christiantigor/smart_rectifier/board_sr/notes_sgp/pin_acs.jpeg

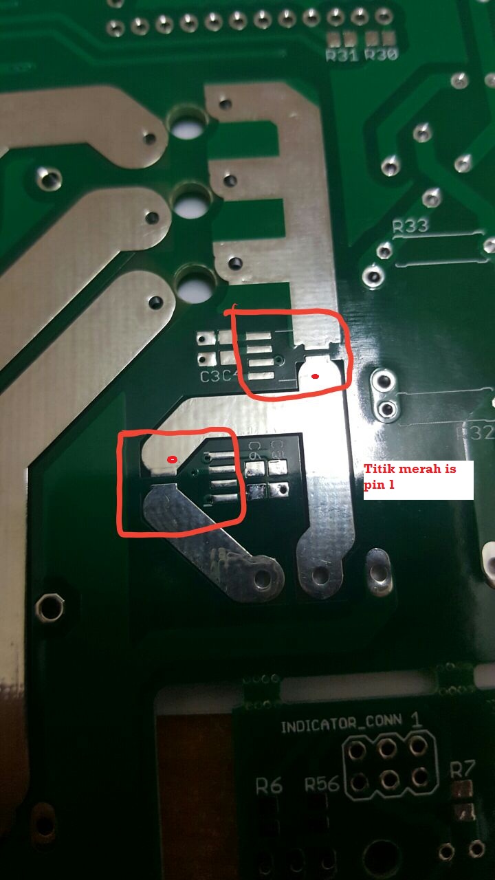
board_sr/notes_sgp/pin_acs.jpeg
