christiantigor/smart_rectifier/document/Troubleshooting.txt

Date and Time
sudo date -s "Wed Mar 16 11:56:45 WIB 2016"
