christiantigor/smart_rectifier/board_sr/sr_controller_v1/NOTES.txt

Revisi untuk board ver1 - OK
- Sudut - sudut buat melengkung
- Resistor dibawah SIM Card holder dipindahkan
- DS1307 dipindahkan sehingga tidak menghalangi spacer
- Tambah rangkaian rectifier untuk AC monitoring
- Tambah tombol reset
