christiantigor/smart_rectifier/casing_sr/TSR_Sticker.pdf

# TSR 15 - 500

01 02

# Switch

AC

# VBUC

+48V

# Switch Battery

# VSCPC

+48V

Hughes HX | VWiFi
Hughes HT iDirect X1&X3 | Bat (+)
| Bat (-)

SIM Net
SIM Stat

Rpi
Ardu

6.5V
19.5V

13.5V
24V - VWiFi

VBat
VSCPC

VAC
VBUC
