christiantigor/smart_rectifier/document/Gantt/TSR_Phase_3.png

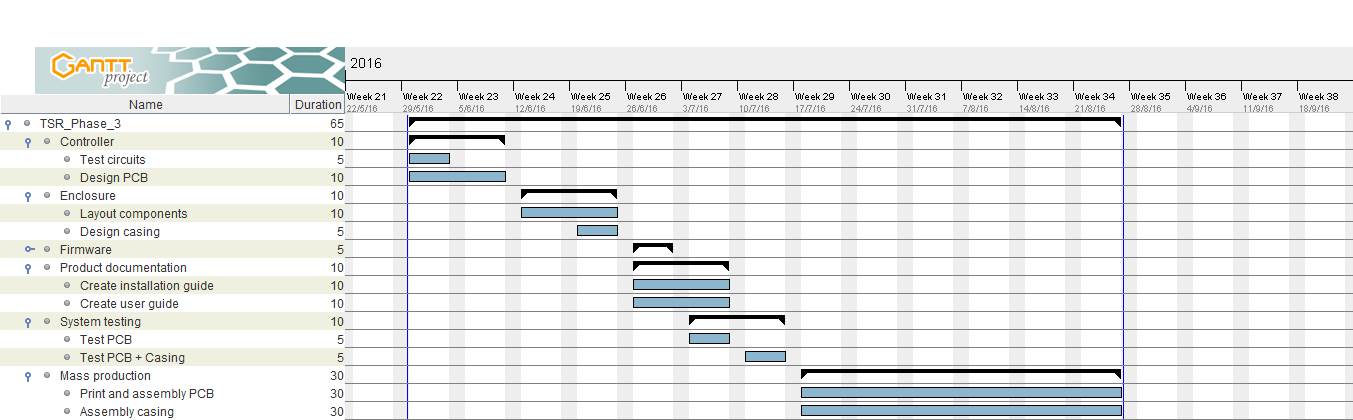
document/Gantt/TSR_Phase_3.png
