christiantigor/smart_rectifier/supply_sr/block_diagram.png

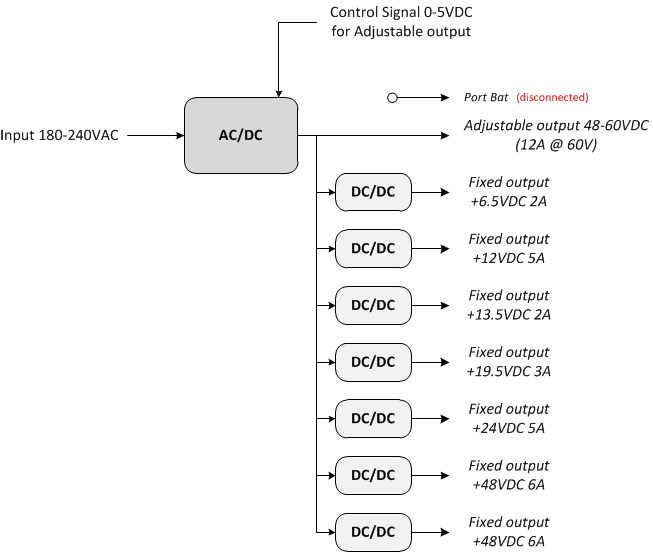
supply_sr/block_diagram.png
