christiantigor/smart_rectifier/supply_sr/block_diagram_rev_a.png

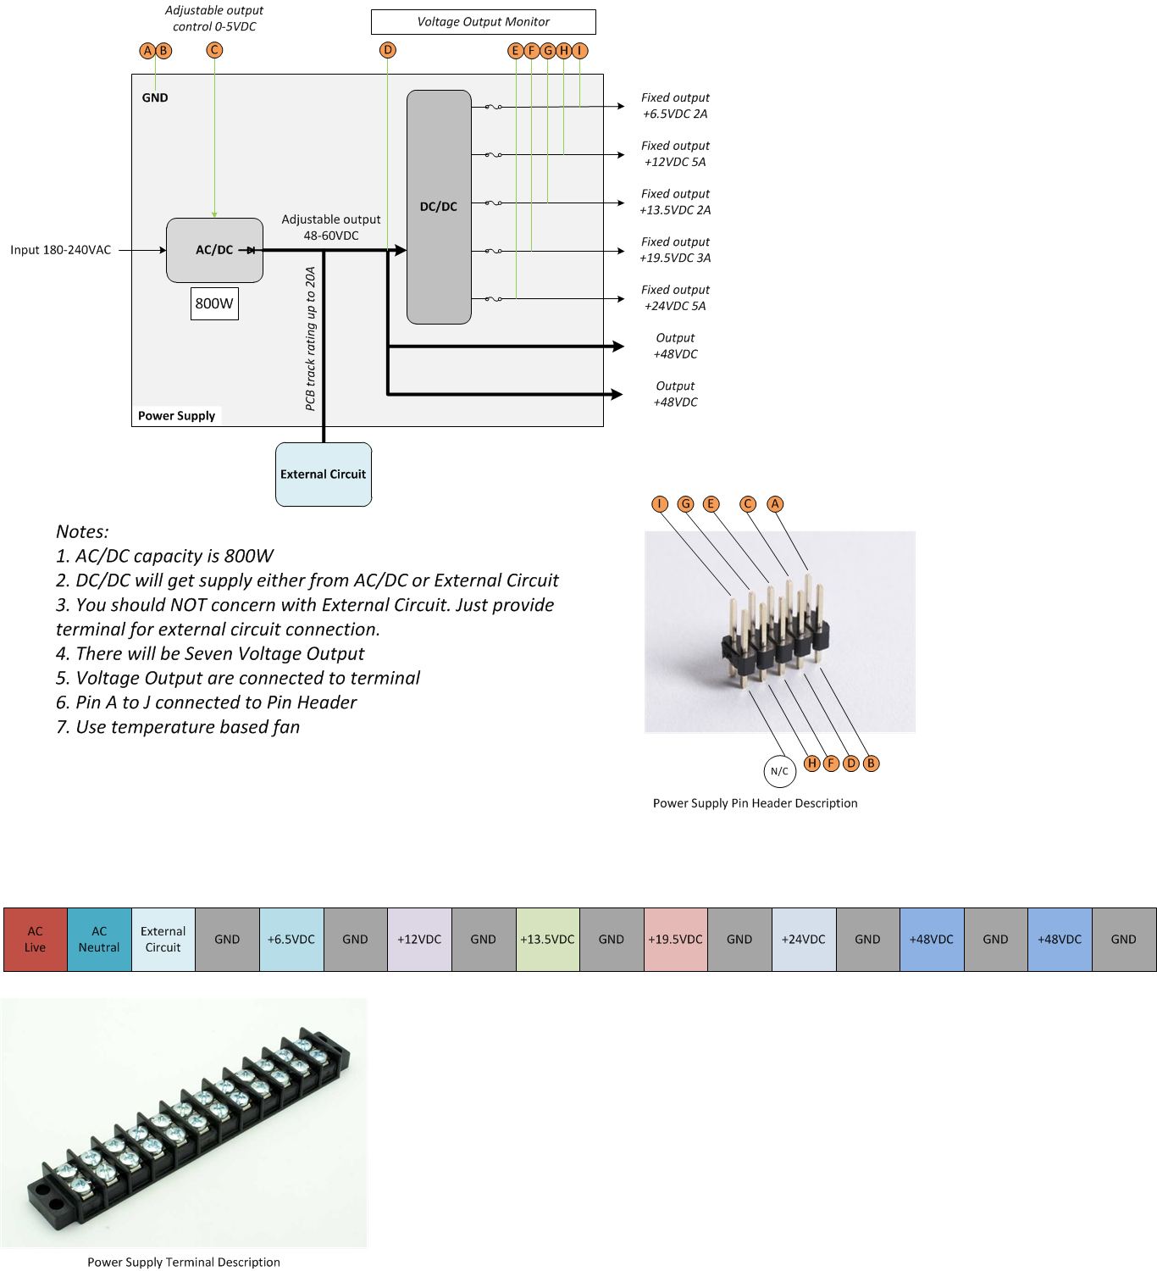
supply_sr/block_diagram_rev_a.png
