christiantigor/smart_rectifier/supply_sr/terminal.png

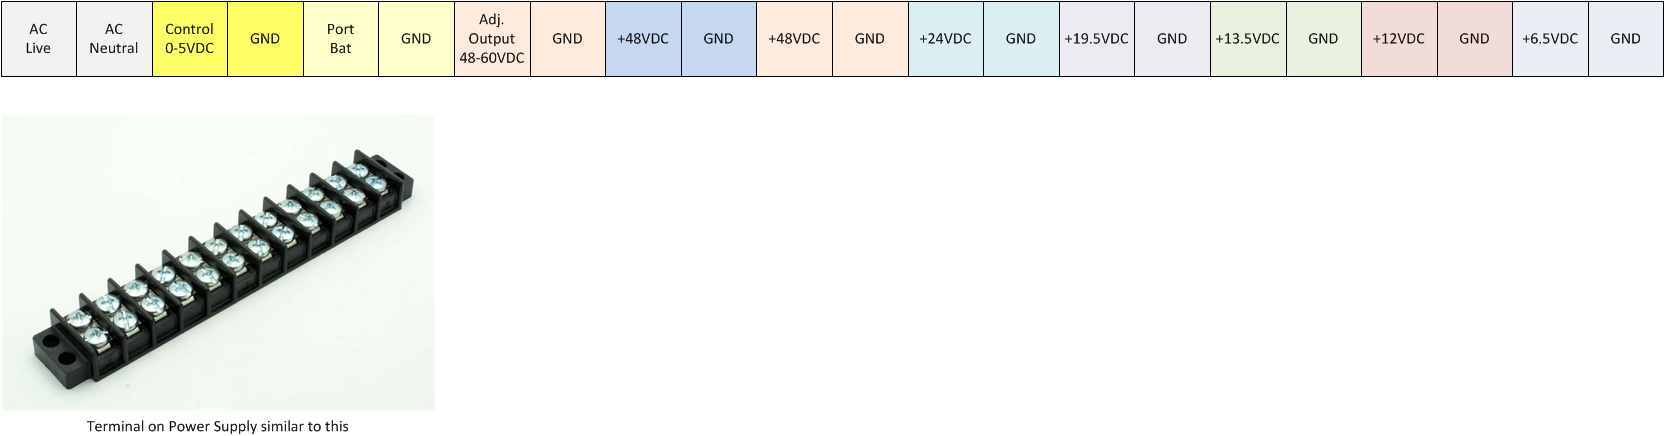
supply_sr/terminal.png
