christiantigor/smart_rectifier/board_sr/sr_controller_v1/sr_controller_v1_revD_BoM.xlsx

Reference | Part Number | Description | Value | Amount | Link
ADJ_VPWRSPLY, FROM_GREY_REG, FROM_LTC_REG_A, FROM_LTC_REG_B, TO_GREY_REG, TO_LTC_REG, VAC | AK300/2 | 2 Pin Blue Connector |  | 7
VPWRSPLY&VBAT | AK300/3 | 3 Pin Blue Connector |  | 1
OUT_+6V5, OUT_+12V, OUT_+13V5, OUT_+19V5, OUT_+24V, OUT_+48V_A, OUT_+48V_B | AK500/2 | 2 Pin Green Connector |  | 7
BAT1 | BATTERY20PTH | Battery Holders |  | 1
FAN | HEADER_1X02 | 2-Pin 0,254cm / 0.1 Header" |  | 1
LED1 | LEDCHIP-LED0805 | LED |  | 1
INDICATOR_CONN | MA03-2 | Male Pin Header |  | 1
T1 | MMBT2222ALT1-NPN-SOT23-BEC | NPN Transistror 2222 |  | 1
B1 | RB1A | Diode Bridge Rectifier |  | 1
U3 | RHT03_DHT-11_AM2302 | DHT 11 Temperature and Humidity Sensor |  | 1
U1 | RTC_DS1307 | DS1307 RTC |  | 1
SJ1, SJ2 | SOLDERJUMPER | leave this unassembled |  | 2
SJ3 | SOLDERJUMPERCLOSED | leave this unassembled |  | 1
SJ6 | SOLDERJUMPERREFLOW | solder the jumper |  | 1
RPI_RESET | TAC_SWITCHPTH | Tactile Switch |  | 1
D1, D2 | 1N4004 | DIODE | 1N4004 | 2
D3 | 1N4728 | Z DIODE | 1N4728 | 1
Q1 | CRYSTALTC38H | CRYSTAL | 32kHz | 1
F1, F2, F3 | BLADE_FUSE_HOLDER | Fuse Holder and The Fuse | 5A | 3
U$7, U$8 | 74HC4053D | Analog Mux | 74HC4053D | 2
U$2, U$4 | ACS712 | Current Sensor | ACS712 | 2
U$1 | ARDUINO_PRO_MINI | Female Pin Header | ARDUINO_PRO_MINI | 1
Q2 | BD140 | PNP TRANSISTOR | BD140 | 1
C3, C5 | C-EUC0805K | C0805 | C100nF | 2
C4, C6 | C-EUC0805K | C0805 | C1nF | 2
C1 | C-EUC0805 | C0805 | C4.7uF | 1
C2 | CPOL-EUE3.5-8 | leave this unassembled | C470uF | 1
U$3, U$6 | DCDCMODULE | Voltage Regulator | DCDCMODULE | 2
IC3 | LM741D | OP AMP | LM741D | 1
R6 | R-EU_R0805 | R0805 | R100K | 1
R55 | NTC642-6 | NTC Thermistor | R10K | 1
R1, R2, R4, R7, R9, R10, R12, R14, R15, R16, R24, R25, R26, R27, R28, R54 | R-EU_R0805 | R0805 | R10K | 16
R5 | R-EU_R0805 | R0805 | R150K | 1
R11, R13, R20, R21, R30, R53 | R-EU_R0805 | R0805 | R1K | 6
R8, R18 | R-EU_R0805 | R0805 | R220R | 2
R32 | R-EU_0309/10 | RESISTOR, European symbol | R270K | 1
R3, R31, R34 | R-EU_R0805 | R0805 | R2K | 3
R57 | R-EU_R0805 | R0805 | R47R | 1
R33 | R-EU_0309/10 | RESISTOR, European symbol | R5.1K | 1
R17, R22, R29 | R-EU_R0805 | R0805 | R5.1K | 3
PCB1 | RASPBERRY_PI_B+_NO_MOUNT | Male Pin Header | RASPBERRY_PI_B+_NO_MOUNT | 1
TV16 | TRANSFORMER | YHDC TV16 2.5mm Transformer | TRANSFORMER | 1
Notes:
Add tin layer on unmasked area on bottom layer
