christiantigor/smart_rectifier/board_sr/sr_indicator_v0/sr_indicator_v0_revB_BoM.xlsx

Reference | Part Number | Description | Value | Amount | Link
LD1 | DUOLED-RG-C | DUO LED |  | 1 | example (http://www.mpja.com/5mm-Red-Green-Bi-Color-LED-Diffused-3-Lead-Common-Cathode/productinfo/17136+OP/)
LED1 | LED5MM | LED |  | 1
INDICATOR_CONN | MA03-2 | PIN HEADER |  | 1
R5, R6, R7 | R-EU_M0805 | RESISTOR, European symbol | R150R | 3
