christiantigor/smart_rectifier/board_sr/sr_controller_v1/sr_controller_v1_revC_BoM.xlsx

Reference | Part Number | Description | Value | Amount | Link
ADJ_VPWRSPLY, FROM_GREY_REG, FROM_LTC_REG_A, FROM_LTC_REG_B, TO_GREY_REG, TO_LTC_REG, VAC, VBAT, VPWRSPLY | AK300/2 | 2 Pin Blue Connector |  | 9 | aliexpress (http://www.aliexpress.com/item/100-pcs-2-Pin-Screw-blue-PCB-Terminal-Block-Connector-5mm-Pitch/32368640798.html)
OUT_+6V5, OUT_+12V, OUT_+13V5, OUT_+19V5, OUT_+24V, OUT_+48V_A, OUT_+48V_B | AK500/2 | 2 Pin Green Connector |  | 7 | aliexpress (http://www.aliexpress.com/item/120-pcs-5-08mm-Angle-2-pin-Screw-Terminal-Block-Connector-Pluggable-Type-Green/32552709836.html)
BAT1 | BATTERY20PTH | Battery Holders |  | 1
INDICATOR_CONN | MA03-2 | Male Pin Header |  | 1
T1 | MMBT2222ALT1-NPN-SOT23-BEC | NPN Transistror 2222 |  | 1
B1 | RB1A | Bridge Rectifier |  | 1
U3 | RHT03_DHT-11_AM2302 | DHT 11 Temperature and Humidity Sensor |  | 1 | aliexpress (http://www.aliexpress.com/item/100pcs-lot-DHT11-Digital-Temperature-And-Humidity-Sensor-FZ0067-Free-Shipping-Dropshipping/877899250.html)
U1 | RTC_DS1307 | DS1307 RTC |  | 1
SJ1, SJ2, SJ4, SJ5 | SOLDERJUMPER | leave this unassembled
SJ3 | SOLDERJUMPERCLOSED | leave this unassembled
SJ6 | SOLDERJUMPERREFLOW | leave this unassembled
RPI_RESET | TAC_SWITCHPTH | Tactile Switch |  | 1
D1, D2 | 1N4004 | DIODE | 1N4004 | 2
D3 | 1N4728 | Z DIODE | 1N4728 | 1
FAN_A | 1X2-3.5MM | 3.5mm Terminal block | 1X2-3.5MM | 1 | image (http://lapantech.com/image/cache/data/white%20housing%202%20pin-384x384.JPG)
Q1 | CRYSTALTC38H | CRYSTAL | 32kHz | 1
F1, F2, F3 | BLADE_FUSE_HOLDER | FUSE HOLDER | 5A | 3 | tokopedia (https://www.tokopedia.com/lek-electronics/fuse-holder-blade-mini-pcb-mount-vertical)
U$8 | 74HC4053D | Analog Mux | 74HC4053D | 1
U$2, U$4 | ACS712 | Current Sensor | ACS712 30A | 2
U$1 | ARDUINO_PRO_MINI | Female Pin Header |  | 1
Q2 | BD140 | PNP TRANSISTOR | BD140 | 1
C3, C5 | C-EUC0805K | C0805 | C100nF | 2
C4, C6 | C-EUC0805K | C0805 | C1nF | 2
C1 | C-EUC0805 | C0805 | C4.7uF | 1
C2 | CPOL-EUE3.5-8 | POLARIZED CAPACITOR, European symbol | C470uF | 1
U$3, U$5, U$6, U$10 | DCDCMODULE | Voltage Regulator |  | 4 | aliexpress (http://www.aliexpress.com/item/DC-DC-Buck-Converter-Step-Down-Module-LM2596-Power-Supply-Output-1-23V-30V/846265709.html)
IC3 | LM741D | OP AMP | LM741D | 1
R6 | R-EU_R0805 | R0805 | R100K | 1
R55 | NTC642-6 | NTC Thermistor | R10K | 1
R1, R2, R4, R7, R10, R12, R14, R15, R16, R24, R25, R26, R27, R28, R54 | R-EU_R0805 | R0805 | R10K | 15
R5 | R-EU_R0805 | R0805 | R150K | 1
R11, R13, R20, R21, R30, R53 | R-EU_R0805 | R0805 | R1K | 6
R8 | R-EU_R0805 | R0805 | R220R | 1
R32 | R-EU_0309/10 | RESISTOR, European symbol | R270K | 1
R3, R31, R34 | R-EU_R0805 | R0805 | R2K | 3
R57 | R-EU_R0805 | R0805 | R47R | 1
R33 | R-EU_0309/10 | RESISTOR, European symbol | R5.1K | 1
R17, R29 | R-EU_R0805 | R0805 | R5.1K | 2
R22 | R-EU_R0805 | R0805 | R5K | 1
PCB1 | RASPBERRY_PI_B+_NO_MOUNT | Male Pin Header | Male Pin Header 2x20 | 1
TV16 | TRANSFORMER | YHDC TV16 2.5mm Transformer | TRANSFORMER | 1 | aliexpress (http://www.aliexpress.com/store/product/YHDC-TV16-250V-2mA-PCB-mount-Voltage-transformer/834088_32294917189.html)
J2, J3, J4, J5, J6, J7, J8, J9 | WIRE_HOLE-14AWG | Connect with 14 AWG Wire | WIRE_HOLE-14AWG | 8
 |  | J2 to J3
 |  | J4 to J5
 |  | J6 to J7
 |  | J8 to J9
