christiantigor/smart_rectifier/board_sr/sr_controller_v1/sr_controller_v1_revB_BoM.xlsx

Reference | Part Number | Description | Value | Amount | Link
BUC_SPLY, MDM_REG_A, MDM_REG_B, SCADA_REG_A, SCADA_REG_B, SCPC_SPLY, TO_LTC_REG, VAC, V_ACCU, V_PWR_SPLY | AK300/2 | 2 Pin Blue Connector |  | 10 | aliexpress (http://www.aliexpress.com/item/100-pcs-2-Pin-Screw-blue-PCB-Terminal-Block-Connector-5mm-Pitch/32368640798.html)
FROM_LTC_REG | AK300/3 | 3 Pin Blue Connector |  | 1 | aliexpress (http://www.aliexpress.com/item/50-pcs-3-Pin-Screw-blue-PCB-Terminal-Block-Connector-5mm-Pitch-301-3P/32616498533.html)
MDM_SPLY_HT_X1_X3 | AK300/5 | 5 Pin Green Connector |  | 1 | aliexpress (http://www.aliexpress.com/item/5-Pcs-Pitch-5-08mm-Angle-5way-pin-Screw-Terminal-Block-Connector-Green-Color-L-Pluggable/1837966907.html)
MDM_SPLY_HX_A, MDM_SPLY_HX_B, SCADA_SPLY | AK500/2 | 2 Pin Green Connector |  | 3 | aliexpress (http://www.aliexpress.com/item/120-pcs-5-08mm-Angle-2-pin-Screw-Terminal-Block-Connector-Pluggable-Type-Green/32552709836.html)
BAT1 | BATTERY20PTH | Battery Holders |  | 1
IC1 | GSM_SIM900_LITERAL | leave this unassembled |  | -
LED1, LED2 | LEDCHIPLED_0805 | leave this unassembled |  | -
INDICATOR_CONN | MA08-2 | Male Pin Header |  | 1
T1, T2, T3, T4 | MMBT2222ALT1-NPN-SOT23-BEC | NPN Transistror 2222 |  | 4
U3 | RHT03_DHT-11_AM2302 | DHT 11 Temperature and Humidity Sensor |  | 1 | aliexpress (http://www.aliexpress.com/item/100pcs-lot-DHT11-Digital-Temperature-And-Humidity-Sensor-FZ0067-Free-Shipping-Dropshipping/877899250.html)
U1 | RTC_DS1307 | DS1307 RTC |  | 1
J1 | SIMHOLDERSIM | leave this unassembled |  | -
X1 | SMACONNECTOR | leave this unassembled |  | -
SJ1, SJ2 | SOLDERJUMPER | leave this unassembled |  | -
SJ3 | SOLDERJUMPERCLOSED | leave this unassembled |  | -
RPI_RESET | TAC_SWITCHPTH | Tactile Switch |  | 1
D3 | TVSARRAY_5LANE | leave this unassembled |  | -
F3 | FUSE2P | Fuse | 10A | 1
D1 | DIODE-DO214AA | Diode | 1N4007 | 1
FAN_A, FAN_B | 1X2-3.5MM | 3.5mm Terminal block | 1X2-3.5MM | 2 | image (http://lapantech.com/image/cache/data/white%20housing%202%20pin-384x384.JPG)
Q1 | CRYSTALTC38H | Crystal | 32kHz | 1
F1, F5 | FUSE2P | Fuse | 4A | 2
U$8 | 74HC4053D | Analog Mux | 74HC4053D | 1
IC2 | 74HC595D | Shift Register | 74HC595D | 1
F4 | FUSE2P | Fuse | 7A | 1
U$2, U$4 | ACS712 | Current Sensor | ACS712 30A | 2
U$1 | ARDUINO_PRO_MINI | Female Pin Header |  | 1
C2, C3, C5 | C-EUC0805K | C0805 | C100N | 3
C10, C12 | C-EUC0805 | C0805 | C100nF | 2
C7, C8 | CPOL-EU153CLV-0605 | Cap Alumunium SMD Polar 0605 | C100uF | 2 | aliexpress (http://www.aliexpress.com/item/SMD-aluminum-electrolytic-capacitor-16V-100UF-6X5-4-100UF-16V-6-5-4-Original-new-Special/32260015566.html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)
C4, C6 | C-EUC0805K | C0805 | C1N | 2
C11, C13 | C-EUC0805 | C0805 | C22pF | 2
C1, C9 | C-EUC0805 | C0805 | C4.7uF | 2
U$3, U$6 | DCDCMODULE | Voltage Regulator |  | 2 | aliexpress (http://www.aliexpress.com/item/DC-DC-Buck-Converter-Step-Down-Module-LM2596-Power-Supply-Output-1-23V-30V/846265709.html)
L1 | L0603 |  | FB0603 | 1 | aliexpress (http://www.aliexpress.com/item/100PCS-0603-150R-150-ohm-SMD-Magnetic-beads-150R-150-ohm-450MA-Ferrite-Universal-BLM18BB151SN1D-BLM18BB151SN1/1926258569.html)
K1 | G5L | RELAY | G5L 12V 10A | 1 | aliexpress (http://www.aliexpress.com/item/Free-shipping-HRS4H-S-DC12V-Relay-electronic-stock-new-original/1634903116.html)
R1, R2, R4, R7, R10, R12, R14, R15, R16, R22, R25, R28, R37, R38, R39, R40, R41, R42, R43, R44, R45, R46, R47, R48, R49, R50, R51 | R-EU_R0805 | R0805 | R10K | 27
R27 | R-EU_R0805 | R0805 | R120R | 1
R5, R6, R11, R13, R21, R24, R30, R35, R36, R53 | R-EU_R0805 | R0805 | R1K | 10
R33 | R-EU_0309/10 | RESISTOR, European symbol | R2.2K | 1
R8, R23, R26 | R-EU_R0805 | R0805 | R220R | 3
R18, R19, R20 | R-EU_R0805 | R0805 | R22R | 3
R32 | R-EU_0309/10 | RESISTOR, European symbol | R270K | 1
R3, R31, R34 | R-EU_R0805 | R0805 | R2K | 3
R9, R52 | R-EU_R0805 | R0805 | R470K | 2
R17, R29 | R-EU_R0805 | R0805 | R5.1K | 2
PCB1 | RASPBERRY_PI_B+_NO_MOUNT | Male Pin Header | Male Pin Header 2x20 | 1
TV16 | TRANSFORMER | YHDC TV16 2.5mm Transformer | TRANSFORMER | 1 | aliexpress (http://www.aliexpress.com/store/product/YHDC-TV16-250V-2mA-PCB-mount-Voltage-transformer/834088_32294917189.html)
J2, J3, J4, J5, J6, J7, J8, J9 | WIRE_HOLE-14AWG | Connect with 14 AWG Wire | WIRE_HOLE-14AWG | 8
 |  | J2 to J3
 |  | J4 to J5
 |  | J6 to J7
 |  | J8 to J9
