christiantigor/smart_rectifier/board_sr/sr_indicator_v0/sr_indicator_v0_BoM.xlsx

Reference | Part Number | Description | Value | Amount
ARDUF, CL0, CL1, CL2, CL3, CL4, CL5, CL6, CL7, CL8, CL9, RPIF, SIMN, SIMS | LED3MM | LED |  | 14
CTRL_CONN | MA08-2 | Male Pin Header |  | 1
R1, R2, R3, R4, R5, R6, R7, R8, R9, R10, R11, R12, R13, R14 | R-EU_M0805 | R0805 | R220R | 14
IC1, IC2 | ULN2004AD | Driver Array | ULN2004AD | 2
