christiantigor/smart_rectifier/board_sr/sr_indicator_v0/sr_indicator_v0.stl

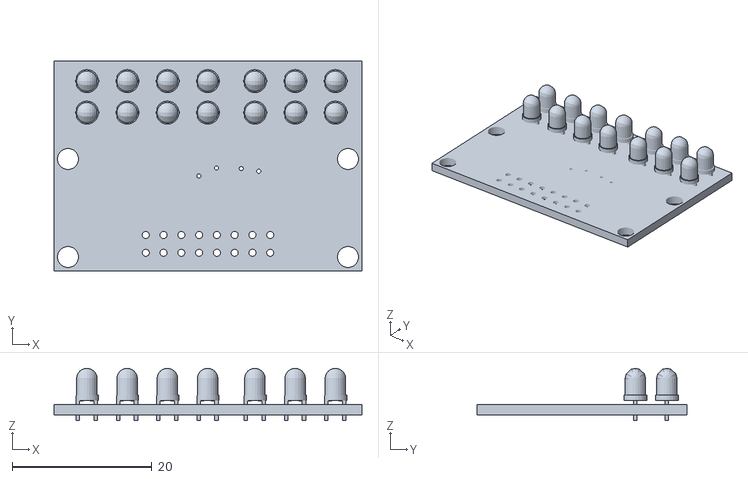
[picture p6: CAD file, 2015-11-06]
board_sr/sr_indicator_v0/sr_indicator_v0.stl
44.0 x 30.0 x 7.48
