christiantigor/smart_rectifier/board_sr/ver_7/sr_controller_v0.stl

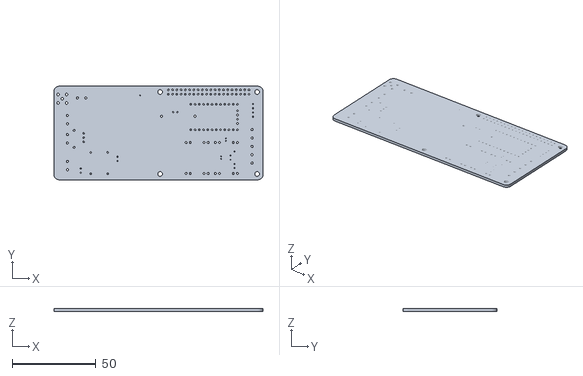
[picture p7: CAD file, 2015-10-19]
board_sr/ver_7/sr_controller_v0.stl
125.0 x 56.0 x 1.50
