christiantigor/smart_rectifier/model/User Library-AC Male Socket with Fuse.stl

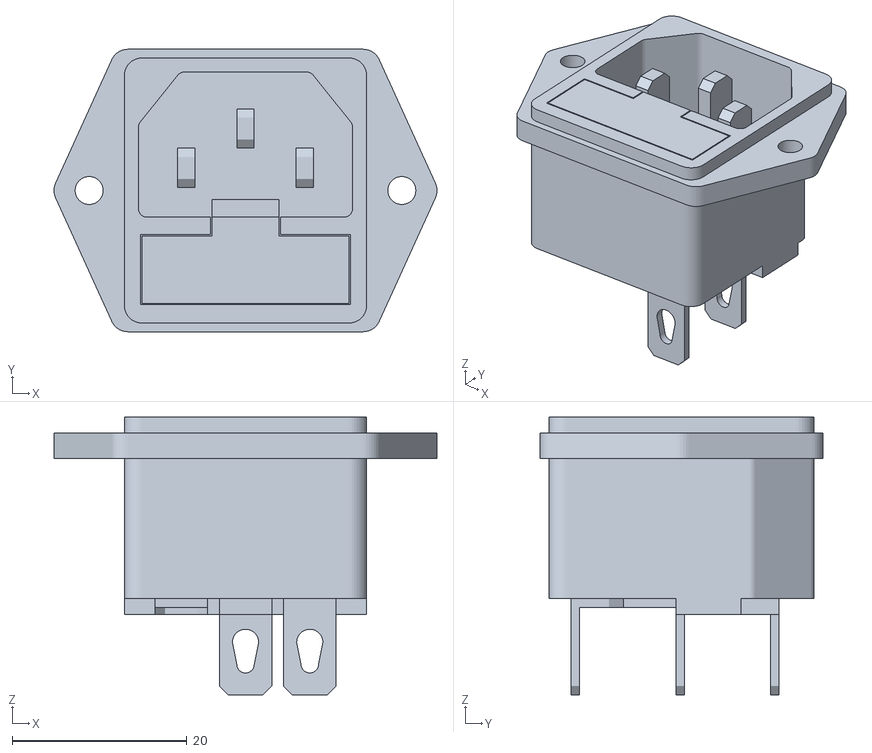
[picture p8: CAD file, 2015-10-19]
model/User Library-AC Male Socket with Fuse.stl
43.8 x 32.3 x 31.8
