christiantigor/smart_rectifier/model/User Library-Switch MIRS-101-2C Red.stl

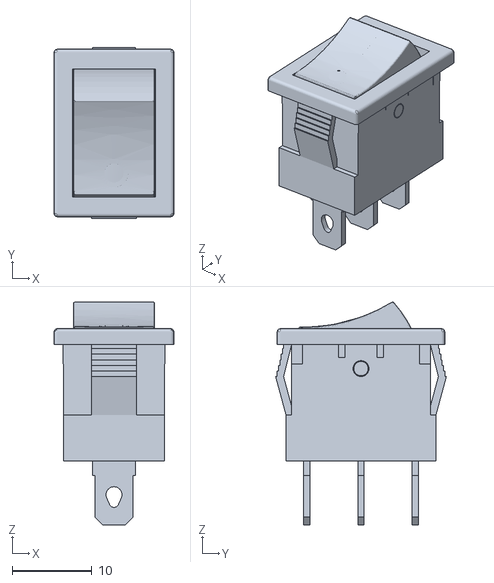
[picture p9: CAD file, 2015-10-19]
model/User Library-Switch MIRS-101-2C Red.stl
15.0 x 21.4 x 27.9
