christiantigor/smart_rectifier/program_sr/rpi/testing/chargingTest.txt

Procedure:
- Truncate DB history (if necessary)
- Turn off cronjob
reboot
- Run pigpiod
- Start prtgprobe
- Run getSensorData.py
- Run control switch manual
