christiantigor/smart_rectifier/program_sr/sensorCalibration.xlsx

Sensor Name | Sensor Value | R1 | R2 | ADC Value | Calibration
VAC
VBat | 50.2 | 10 | 0.22 | 221.3122505 | 0.2268288
BUC | 48 | 10 | 1 | 893.6727273 | 0.0537109
SCADA | 12 | 10 | 5.1 | 830.0503311 | 0.014457
SCPC | 48 | 10 | 1 | 893.6727273 | 0.0537109
Modem0 | 6.5 | 10 | 10 | 665.6 | 0.0097656
Modem1 | 13.5 | 10 | 5.1 | 933.8066225 | 0.014457
Modem2 | 19.5 | 10 | 2 | 665.6 | 0.0292969
Modem3 | 24 | 10 | 2 | 819.2 | 0.0292969
Sensor Name | Sensitivity(V/A) | Unit ADC in Volt(V/ADC) | Unit ADC in Amp(A/ADC)
IBat | 0.066 | 0.0048828125 | 0.073982
ILoad | 0.066 | 0.0048828125 | 0.073982
