christiantigor/smart_rectifier/program_sr/vacCalibration.xlsx

Sheet: Sheet1
x | y | xy | x2 | y2 | n | Σ x | Σ y | Σ xy | Σx2 | Σy2
473 | 220 | 104060 | 223729 | 48400 | 5 | 2245 | 900 | 406980 | 1010281 | 166000
462 | 200 | 92400 | 213444 | 40000
458 | 180 | 82440 | 209764 | 32400 |  | (Σx)2 | (Σy)2
440 | 160 | 70400 | 193600 | 25600 |  | 5040025 | 810000
412 | 140 | 57680 | 169744 | 19600
 |  |  |  |  |  | m | 1.265377856
 |  |  |  |  |  | b | -388.1546573
 |  |  |  |  |  | x is adc
 |  |  |  |  |  | y is vac
 |  |  |  |  |  | y = mx +b

Sheet: Sheet2
x | y | xy | x2 | y2 | n | Σ x | Σ y | Σ xy | Σx2 | Σy2
479 | 220 | 105380 | 229441 | 48400 | 5 | 2361 | 900 | 425700 | 1114995 | 166000
476 | 200 | 95200 | 226576 | 40000
473 | 180 | 85140 | 223729 | 32400 |  | (Σx)2 | (Σy)2
468 | 160 | 74880 | 219024 | 25600 |  | 5574321 | 810000
465 | 140 | 65100 | 216225 | 19600
 |  |  |  |  |  | m | 5.504587156
 |  |  |  |  |  | b | -2419.266055
 |  |  |  |  |  | x is adc
 |  |  |  |  |  | y is vac
 |  |  |  |  |  | y = mx +b
