christiantigor/smart_rectifier/program_sr/rpi/testing/chargingLoad.xlsx

 |  | VBAT | IBAT | ILOAD
2015-11-24 | 16:28:07 | 48.32 | -5.99 | 5.47 | Tanpa charging dan beban terhubung
2015-11-24 | 16:28:23 | 48.32 | -5.99 | 5.4
2015-11-24 | 16:28:39 | 48.32 | -5.99 | 5.47
2015-11-24 | 16:28:55 | 48.32 | -5.99 | 5.4
2015-11-24 | 16:29:16 | 48.32 | -5.99 | 5.47
2015-11-24 | 16:29:32 | 48.32 | -5.99 | 5.47
2015-11-24 | 16:29:48 | 48.32 | -5.99 | 5.47
2015-11-24 | 16:30:04 | 48.32 | -5.99 | 5.47
2015-11-24 | 16:30:20 | 48.32 | -5.99 | 5.47
2015-11-24 | 16:30:36 | 48.32 | -5.99 | 5.47
2015-11-24 | 16:30:52 | 48.32 | -5.99 | 5.47
2015-11-24 | 16:31:08 | 48.32 | -5.99 | 5.47
2015-11-24 | 16:31:24 | 51.12 | 6.95 | 5.92 | Charging dan beban terhubung
2015-11-24 | 16:31:40 | 51.82 | 6.81 | 5.99
2015-11-24 | 16:31:56 | 53.22 | 6.66 | 5.99
2015-11-24 | 16:32:22 | 53.92 | 6.36 | 6.07
2015-11-24 | 16:32:38 | 54.38 | 6.29 | 6.14
2015-11-24 | 16:32:59 | 54.62 | 6.21 | 6.07
2015-11-24 | 16:33:15 | 54.62 | 5.99 | 6.07
2015-11-24 | 16:33:31 | 58.12 | 11.69 | 0.15 | Fuse putus
2015-11-24 | 16:33:47 | 56.72 | 9.91 | 0.15
2015-11-24 | 16:34:03 | 58.35 | 9.32 | -0.07
2015-11-24 | 16:34:19 | 57.65 | 9.03 | -0.07
2015-11-24 | 16:34:35 | 57.89 | 8.66 | 0.15
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
