christiantigor/smart_rectifier/program_sr/rpi/testing/chargingWOLoad.xlsx

2015-11-24 | 14:18:56 | 573 | 50.88 | -0.52 | 0 | Hughes HX-50 | 6.59 | 13.56 | 19.58 | 24.19 | 50.8 | 50.94 | 12 | 27 | 0
2015-11-24 | 14:19:12 | 566 | 50.88 | -0.52 | 0 | Hughes HX-50 | 6.59 | 13.57 | 19.58 | 24.19 | 50.86 | 50.94 | 12 | 26 | 0
2015-11-24 | 14:19:28 | 598 | 50.88 | -0.52 | 0 | Hughes HX-50 | 6.59 | 13.57 | 19.58 | 24.19 | 50.8 | 50.88 | 12 | 26 | 0
2015-11-24 | 14:19:44 | 556 | 50.88 | -0.52 | 0 | Hughes HX-50 | 6.59 | 13.57 | 19.58 | 24.19 | 50.8 | 50.88 | 11.98 | 27 | 0
2015-11-24 | 14:20:00 | 596 | 50.88 | -0.52 | 0 | Hughes HX-50 | 6.59 | 13.57 | 19.58 | 24.19 | 50.8 | 50.88 | 12 | 27 | 0
2015-11-24 | 14:20:16 | 561 | 50.88 | -0.52 | 0 | Hughes HX-50 | 6.59 | 13.56 | 19.58 | 24.19 | 50.86 | 50.88 | 12.01 | 27 | 0
2015-11-24 | 14:20:32 | 560 | 50.88 | -0.52 | 0 | Hughes HX-50 | 6.59 | 13.57 | 19.58 | 24.19 | 50.8 | 50.88 | 12 | 27 | 0
2015-11-24 | 14:20:58 | 585 | 50.88 | -0.52 | -0.15 | Hughes HX-50 | 6.59 | 13.57 | 19.61 | 24.19 | 50.91 | 50.99 | 12.05 | 27 | 0
2015-11-24 | 14:21:14 | 596 | 50.88 | -0.52 | -0.07 | Hughes HX-50 | 6.59 | 13.56 | 19.58 | 24.19 | 50.8 | 50.88 | 12 | 26 | 0
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
