christiantigor/smart_rectifier/program_sr/rpi/sensorHistory.txt

tdate	ttime	sensorVAC	sensorVBat	sensorIBat	sensorILoad	modemType	sensorModem0	sensorModem1	sensorModem2	sensorModem3	sensorBUC	sensorSCPC	sensorSCADA	sensorTemp	sendStatus
2015-11-29	19:16:03	402	50.65	-0.52	0.15	Hughes HX-50	6.61	13.59	19.58	24.16	50.53	50.56	11.98	25	1
2015-11-29	19:18:09	403	50.65	-0.52	0.15	Hughes HX-50	6.61	13.59	19.58	24.16	50.53	50.56	11.98	25	1
2015-11-29	19:20:13	403	50.65	-0.52	0.15	Hughes HX-50	6.61	13.59	19.61	24.16	50.48	50.51	11.98	25	1
2015-11-29	19:22:04	403	50.65	-0.52	0.15	Hughes HX-50	6.61	13.59	19.61	24.19	50.48	50.51	11.98	25	1
2015-11-29	19:24:05	403	50.65	-0.52	0.15	Hughes HX-50	6.61	13.59	19.58	24.16	50.48	50.51	11.98	25	1
2015-11-29	19:26:04	403	50.65	-0.52	0.15	Hughes HX-50	6.61	13.59	19.58	24.16	50.43	50.51	11.98	25	1
2015-11-29	19:28:14	405	50.65	-0.52	0.15	Hughes HX-50	6.61	13.59	19.61	24.16	50.43	50.51	11.98	26	1
2015-11-29	19:30:05	406	50.42	-0.52	0.15	Hughes HX-50	6.61	13.59	19.58	24.16	50.43	50.51	11.98	26	1
2015-11-29	19:32:04	405	50.42	-0.52	0.15	Hughes HX-50	6.61	13.59	19.61	24.16	50.43	50.45	11.98	26	1
2015-11-29	19:34:04	405	50.42	-0.52	0.15	Hughes HX-50	6.61	13.59	19.61	24.16	50.43	50.45	11.98	26	1
2015-11-29	19:36:04	405	50.42	-0.52	0.15	Hughes HX-50	6.61	13.59	19.58	24.16	50.43	50.45	11.98	26	1
2015-11-29	19:38:04	405	50.42	-0.52	0.15	Hughes HX-50	6.61	13.59	19.61	24.16	50.37	50.45	11.98	25	1
2015-11-29	19:40:04	406	50.42	-0.52	0.15	Hughes HX-50	6.61	13.59	19.58	24.16	50.37	50.4	11.98	25	1
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
2015-12-08	23:17:28	228.71	50.88	-0.52	0.15	NULL	6.61	13.57	19.58	24.16	50.64	50.67	11.97	25	0
2015-12-08	23:17:29	217.7	50.65	-0.52	0.15	NULL	6.61	13.57	19.61	24.16	50.64	50.67	11.98	25	1
2015-12-08	23:17:30	228.71	50.88	-0.52	0.22	NULL	6.61	13.57	19.58	24.16	50.64	50.67	11.98	25	1
