christiantigor/smart_rectifier/casing_sr/TSR_v0.pdf

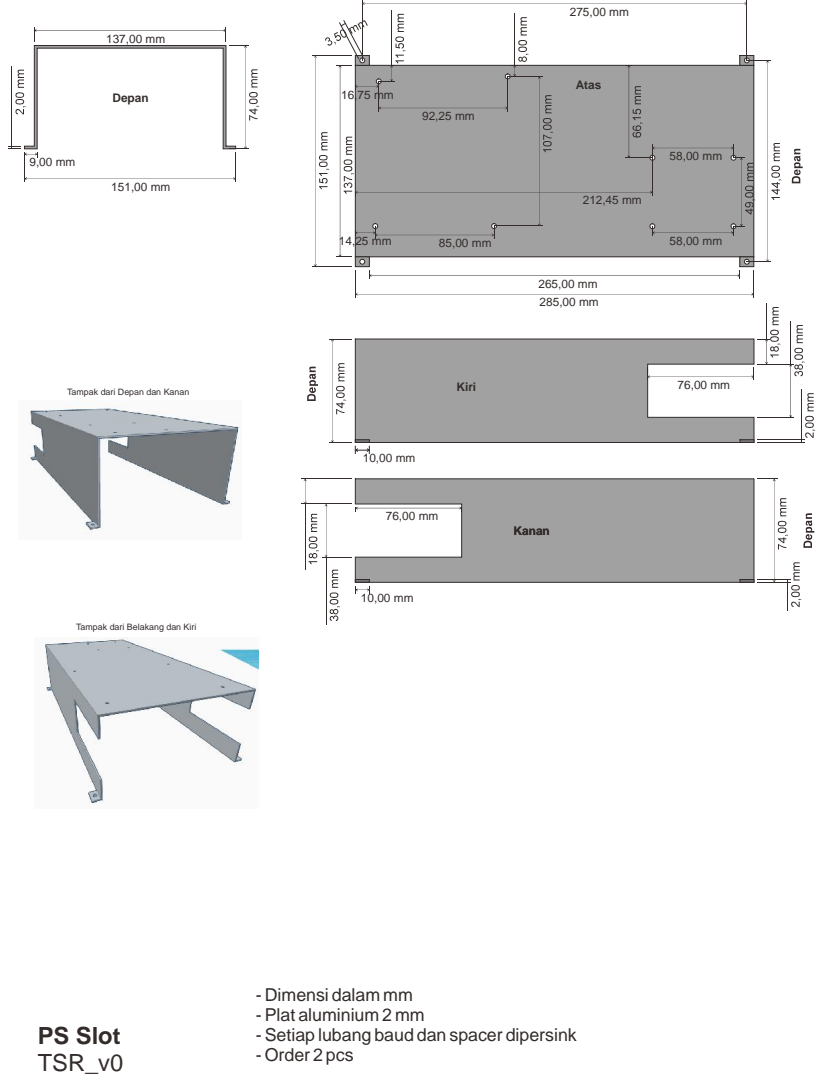
[picture p10: page 1]
Kiri; Kanan; Tampak dari Depan dan Kanan; Atas; Depan; PS Slot TSR_v0

Tampak dari Belakang dan Kiri

- Dimensi dalam mm
- Plat aluminium 2 mm
- Setiap lubang baud dan spacer dipersink
- Order 2 pcs

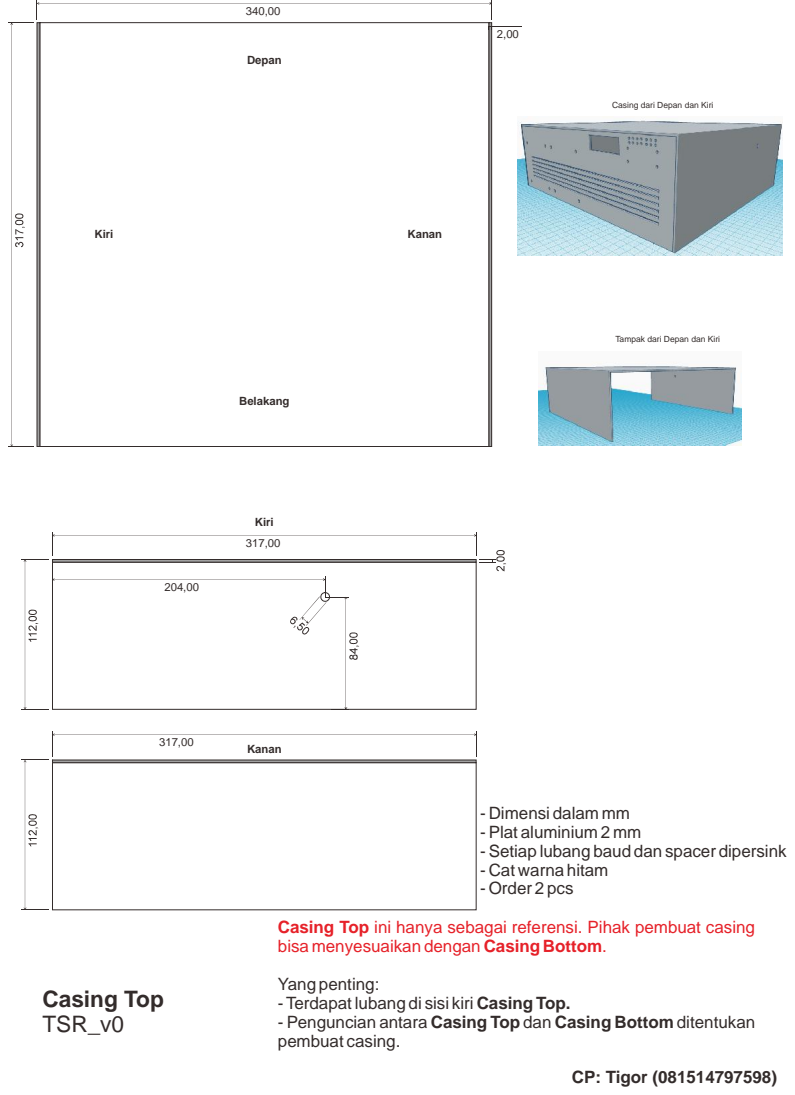
[picture p11: page 2]
Depan; Belakang; Kiri; Kanan; Kanan 317,00; Casing Bottom; bisa menyesuaikan dengan; - Penguncian antara; dan; ditentukan; Casing Top.; Casing Top; CP: Tigor (081514797598)

Casing dari Depan dan Kiri

Tampak dari Depan dan Kiri

- Dimensi dalam mm
- Plat aluminium 2 mm
- Setiap lubang baud dan spacer dipersink
- Cat warna hitam
- Order 2 pcs

Casing Top
Yang penting:
- Terdapat lubang di sisi kiri
pembuat casing.

ini hanya sebagai referensi. Pihak pembuat casing

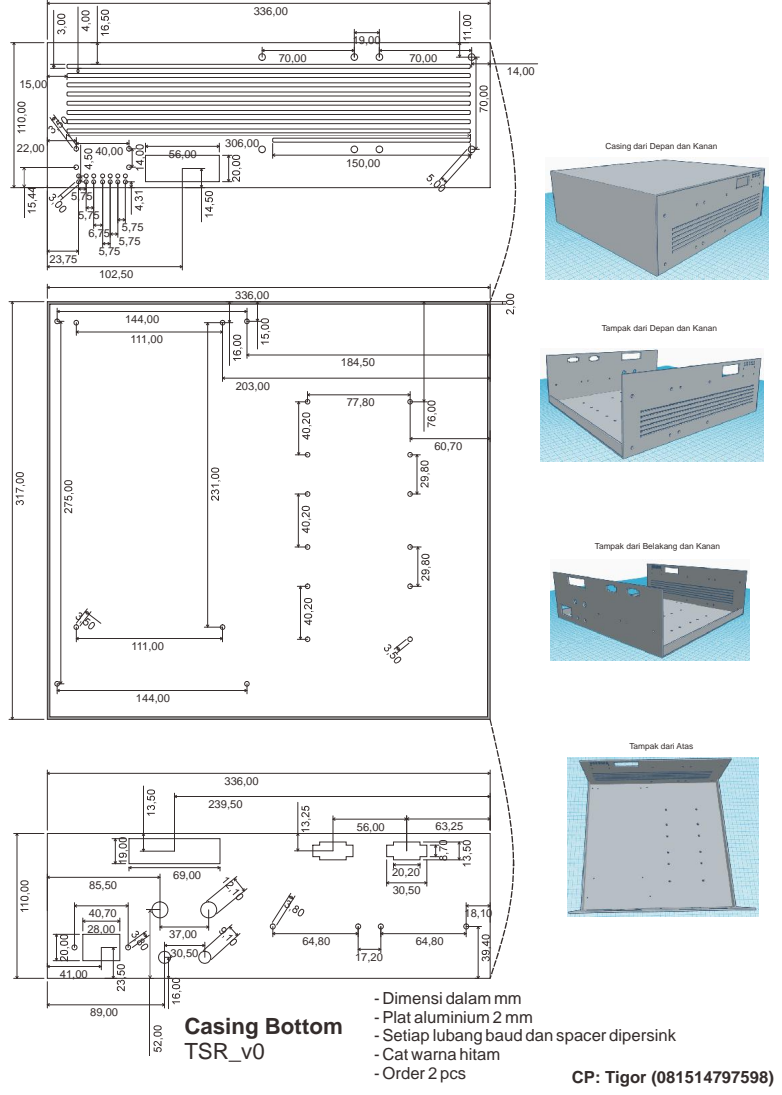
[picture p12: page 3]
Casing Bottom; CP: Tigor (081514797598)

Casing dari Depan dan Kanan

Tampak dari Depan dan Kanan

Tampak dari Belakang dan Kanan

Tampak dari Atas

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
