christiantigor/smart_rectifier/casing_sr/PS_Slot.pdf

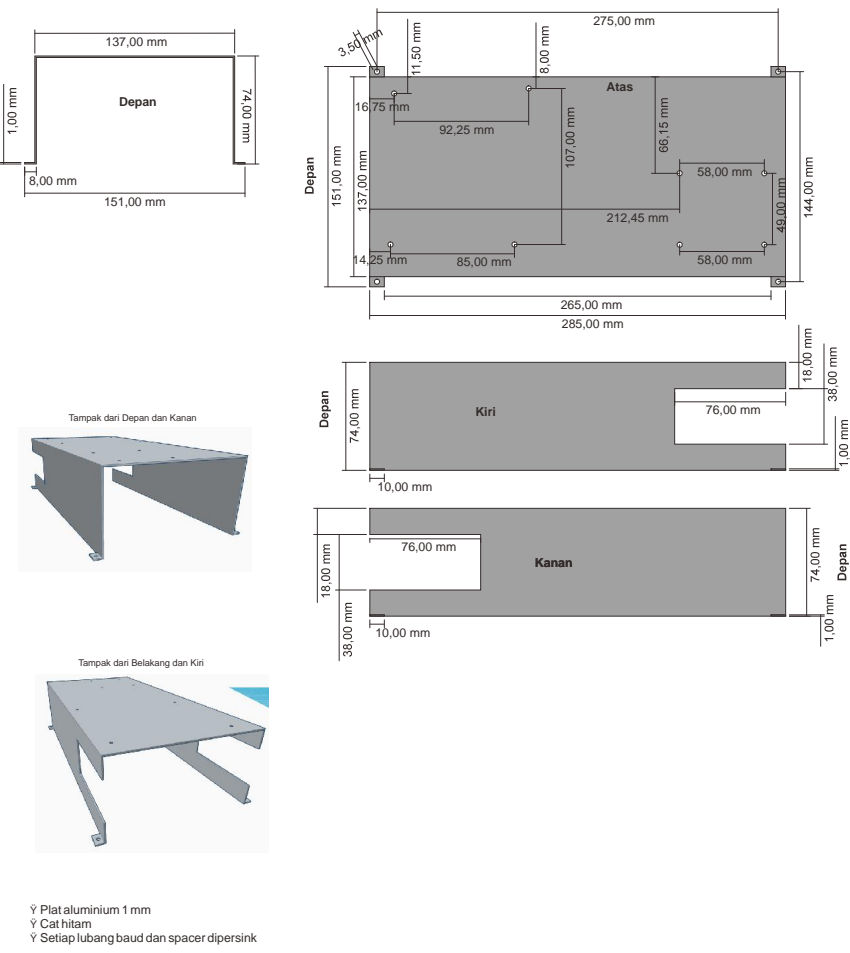
[picture p13: page 1]
Kiri; Kanan; Tampak dari Depan dan Kanan; Atas; Depan

Tampak dari Belakang dan Kiri

Plat aluminium 1 mm
Cat hitam
Setiap lubang baud dan spacer dipersink
