christiantigor/smart_rectifier/board_sr/sr_controller_v1/sr_controller_v1_revA.brd

## EAGLE design board_sr/sr_controller_v1/sr_controller_v1_revA.brd (2017-06-01)

Schematic: sr_controller_v1_revA.sch

Parts:
BAT1: BATTERY20PTH; BATTCOM_20MM_PTH
BUC_SPLY: AK300/2
C1, C9: C4.7uF; C0805
C3, C5, C14: C100N; C0805K
C4, C6: C1N; C0805K
C7, C8: C100uF; 153CLV-0605
C10, C12: C100nF; C0805
C11, C13: C22pF; C0805
D1: 1N4007; DO214AA
D3: TVSARRAY_5LANE; SOT363
DUMMY_A: AK500/2
DUMMY_B: AK500/2
DUMMY_C: AK500/2
F1, F5: 4A; FUSE1
F3: 10A; FUSE1
F4: 7A; FUSE1
FAN_A: 1X2-3.5MM
FAN_B: 1X2-3.5MM
FROM_LTC_REG: AK300/3
IC1: GSM_SIM900_LITERAL; SIM900_SMT
IC2: 74HC595D; SO16
INDICATOR_CONN: MA08-2
J1: SIMHOLDERSIM; SIMHOLDER
J2, J3, J4, J5, J6, J7, J8, J9: WIRE_HOLE-14AWG
K1: G5L; G5LE
LED1, LED2: LEDCHIPLED_0805; CHIPLED_0805
MDM_REG_A: AK300/2
MDM_REG_B: AK300/2
MDM_SPLY_HT_X1_X3: AK300/5
MDM_SPLY_HX_A: AK500/2
MDM_SPLY_HX_B: AK500/2
PCB1: RASPBERRY_PI_B+_NO_MOUNT; RASPBERRY_PI_B+
Q1: 32kHz; TC38H
R1, R2, R4, R7, R10, R12, R14, R15, R16, R22, R25, R28, R37, R38, R39, R40, R41, R42, R43, R44, R45, R46, R47, R48, R49, R50, R51: R10K; R0805
R3, R31, R34: R2K; R0805
R5, R6, R11, R13, R21, R24, R30, R35, R36: R1K; R0805
R8, R23, R26: R220R; R0805
R17, R29: R5.1K; R0805
R18, R19, R20: R22R; R0805
R27: R120R; R0805
R32: R270K; 0309/10
R33: R5.1K; 0309/10
SCADA_REG_A: AK300/2
SCADA_REG_B: AK300/2
SCADA_SPLY: AK500/2
SCPC_SPLY: AK300/2
SJ1, SJ2: SOLDERJUMPER; SOLDERJUMPER_ARROW_NOPASTE
SJ3: SOLDERJUMPERCLOSED; SOLDERJUMPER_CLOSEDWIRE
T1, T2, T3, T4: MMBT2222ALT1-NPN-SOT23-BEC; SOT23-BEC
TO_LTC_REG: AK300/2
U1: RTC_DS1307; SOIC8_150MIL
U3: RHT03_DHT-22_AM2302; RHT03_DHT-22
U$1: ARDUINO_PRO_MINI
U$2, U$4: ACS712; SO08
U$3, U$6: DCDCMODULE
U$5: FB0603; L0603
U$8: 74HC4053D; SO16
U$9: TRANSFORMER; TV16
VAC: AK300/2
V_ACCU: AK300/2
V_PWR_SPLY: AK300/2
X1: SMACONNECTOR; SMA90_DIP

Connections:
+3V3: R23.1, R26.1, R37.1, R38.1, R44.1, SJ2.2, U$5.2
+5V: C1.2, C3.2, C5.2, IC2.16 (VCC), INDICATOR_CONN.15, PCB1.2 (5V0), PCB1.4 (5V0), R1.1, R39.1, R40.1, R41.1, R42.1, R43.1, R45.1, R46.1, R47.1, R48.1, R49.1, R50.1, R51.1, SJ1.2, U1.8 (VCC), U3.VDD, U$1.21 (VCC), U$2.8 (VCC), U$4.8 (VCC), U$8.16 (VCC)
+6.5V: FROM_LTC_REG.3, MDM_SPLY_HX_A.1, R14.1
+13.5V: FROM_LTC_REG.1, MDM_SPLY_HT_X1_X3.4, R28.1
+19.5V: FROM_LTC_REG.2, MDM_SPLY_HX_A.2, R2.1
AGND: C3.1, C4.1, C5.1, C6.1, C14.1, SJ3.2, U$2.5 (GND), U$4.5 (GND)
ARDU_FLASH: INDICATOR_CONN.4, R45.2, U$1.14 (*11)
ARDU_RX: PCB1.26 (!CE!/GPIO7), U$1.2 (RXI)
ARDU_TX: PCB1.24 (!CE0!/GPIO8), R30.2, R31.1
CTRL_CHARGING: PCB1.40 (GPIO21), R6.1
CTRL_LED0: IC2.15 (QA), INDICATOR_CONN.13, R43.2
CTRL_LED1: IC2.1 (QB), INDICATOR_CONN.14, R51.2
CTRL_LED2: IC2.2 (QC), INDICATOR_CONN.11, R42.2
CTRL_LED3: IC2.3 (QD), INDICATOR_CONN.12, R50.2
CTRL_LED4: IC2.4 (QE), INDICATOR_CONN.9, R41.2
CTRL_LED5: IC2.5 (QF), INDICATOR_CONN.10, R49.2
CTRL_LED6: IC2.6 (QG), INDICATOR_CONN.7, R40.2
CTRL_LED7: IC2.7 (QH), INDICATOR_CONN.8, R48.2
CTRL_LED8: INDICATOR_CONN.5, R39.2, U$1.15 (12)
CTRL_LED9: INDICATOR_CONN.6, R46.2, U$1.16 (13)
CTRL_SIM_PWRKEY: PCB1.12 (GPIO18), R27.1
DHT_DATA: R1.2, U3.DATA, U$1.13 (*10)
GND: BAT1.2 (-), BUC_SPLY.2, C1.1, C7.-, C8.-, C9.1, C10.1, C11.1, C12.1, C13.1, D3.2 (A), FAN_A.1, FAN_B.1, IC1.P$17 (GND), IC1.P$18 (GND), IC1.P$29 (GND), IC1.P$39 (GND), IC1.P$45 (GND), IC1.P$46 (GND), IC1.P$53 (GND), IC1.P$54 (GND), IC1.P$58 (GND), IC1.P$59 (GND), IC1.P$61 (GND), IC1.P$62 (GND), IC1.P$63 (GND), IC1.P$64 (GND), IC1.P$65 (GND), IC2.8 (GND), IC2.13 (G), INDICATOR_CONN.16, J1.C5 (GND), MDM_REG_A.2, MDM_REG_B.1, MDM_SPLY_HT_X1_X3.2, MDM_SPLY_HX_B.1, PCB1.9 (GND), PCB1.25 (GND), PCB1.39 (GND), R3.2, R8.2, R11.2, R13.2, R15.2, R17.2, R22.1, R25.1, R29.2, R31.2, R34.2, SCADA_REG_A.2, SCADA_REG_B.1, SCADA_SPLY.2, SCPC_SPLY.2, SJ3.1, T1.E, T2.E, T3.E, T4.E, TO_LTC_REG.2, U1.4 (GND), U3.GND, U$1.4 (GND), U$1.23 (GND), U$3.GND#0 (GNDI), U$3.GND#1 (GNDO), U$6.GND#0 (GNDI), U$6.GND#1 (GNDO), U$8.6 (/E), U$8.7 (VEE), U$8.8 (GND), V_ACCU.1, V_PWR_SPLY.1, X1.GND1, X1.GND2, X1.GND3, X1.GND4
GPIO11: IC1.P$67 (GPIO11)
GPIO12: IC1.P$68 (GPIO12)
MDM_INDC_0: MDM_SPLY_HX_B.2, PCB1.38 (GPIO20), R5.2
MDM_INDC_1: MDM_SPLY_HT_X1_X3.1, PCB1.32 (GPIO12), R35.2
MDM_INDC_2: MDM_SPLY_HT_X1_X3.3, PCB1.36 (GPIO16), R36.2
unnamed: R32.1, VAC.2
unnamed: U$9.IB, VAC.1
unnamed: Q1.1, U1.1 (X1)
unnamed: Q1.2, U1.2 (X2)
unnamed: BAT1.1 (+), U1.3 (VBAT)
unnamed: U$8.13 (1Y1), U$8.15 (2Z)
unnamed: U$8.4 (3Z), U$8.12 (1Y0)
unnamed: SJ1.1, U$3.VOUT
unnamed: SJ2.1, U$6.VOUT
unnamed: C4.2, U$2.6 (FILT)
unnamed: R6.2, T4.B
unnamed: C6.2, U$4.6 (FILT)
unnamed: F1.1A, MDM_REG_B.2
unnamed: F3.1A, SCADA_REG_B.2
unnamed: IC1.P$60 (RF_ANT), X1.ANTENNA (ANT)
unnamed: C7.+, C8.+, IC1.P$55 (VBAT1), IC1.P$56 (VBAT2), IC1.P$57 (VBAT3), U$5.1
unnamed: C9.2, IC1.P$26 (VRTC)
unnamed: IC1.P$33 (SIM_RST), R18.1
unnamed: IC1.P$32 (SIM_CLK), R19.1
unnamed: IC1.P$31 (SIM_DATA), R20.1
unnamed: LED1.C, T1.C
unnamed: LED1.A, R23.2
unnamed: LED2.C, T2.C
unnamed: R21.2, R22.2, T1.B
unnamed: LED2.A, R26.2
unnamed: R24.2, R25.2, T2.B
unnamed: R27.2, T3.B
unnamed: D1.A, K1.2, T4.C
unnamed: R30.1, U$1.1 (TXO)
unnamed: R32.2, U$9.IA
unnamed: C14.2, R33.1, U$9.OB
RPI_3V3: PCB1.17 (3V3), R5.1, R35.1, R36.1
RPI_FLASH: INDICATOR_CONN.3, PCB1.16 (GEN4/GPIO23), R38.2
RTC_SCL: PCB1.5 (GPIO3/SCL1), U1.6 (SCL)
RTC_SDA: PCB1.3 (GPIO2/SDA1), U1.5 (SDA)
SEL_SENSOR_1: U$1.12 (*9), U$8.11 (S1)
SEL_SENSOR_2: U$1.11 (8), U$8.10 (S2)
SEL_SENSOR_3: U$1.10 (7), U$8.9 (S3)
SENSOR_BUC: R12.2, R13.1, U$1.25 (A4)
SENSOR_IBAT: U$1.18 (A1), U$4.7 (VOUT)
SENSOR_ILOAD: U$1.20 (A3), U$2.7 (VOUT)
SENSOR_MDM: U$1.27 (A6), U$8.14 (1Z)
SENSOR_MDM_0: R14.2, R15.1, U$8.5 (3Y0)
SENSOR_MDM_1: R28.2, R29.1, U$8.2 (2Y0)
SENSOR_MDM_2: R2.2, R3.1, U$8.3 (3Y1)
SENSOR_MDM_3: R4.2, R34.1, U$8.1 (2Y1)
SENSOR_SCADA: R16.2, R17.1, U$1.26 (A5)
SENSOR_SCPC: R10.2, R11.1, U$1.28 (A7)
SENSOR_VAC: R33.2, U$1.17 (A0), U$9.OA
SENSOR_VBAT: R7.2, R8.1, U$1.19 (A2)
SIM_NETLIGHT: IC1.P$52 (NETLIGHT), INDICATOR_CONN.1, R24.1, R37.2
SIM_PWRKEY: IC1.P$1 (PWRKEY), T3.C
SIM_RX: IC1.P$10 (RXD), PCB1.8 (TXD0/GPIO14)
SIM_STATUS: IC1.P$66 (STATUS), INDICATOR_CONN.2, R21.1, R44.2
SIM_TX: IC1.P$9 (TXD), PCB1.10 (RXD0/GPIO15)
SR_DS: IC2.14 (SER), U$1.8 (*5)
SR_RST: IC2.10 (SCL), R47.2, U$1.5 (2)
SR_SHCP: IC2.11 (SCK), U$1.6 (*3)
SR_STCP: IC2.12 (RCK), U$1.7 (4)
USIM_CLK: D3.4 (C3), J1.C3 (CLK), R19.2
USIM_DATA: D3.1 (C1), J1.C7 (I/O), R20.2
USIM_RST: D3.3 (C2), J1.C2 (RST), R18.2
USIM_VDD: C10.2, C11.2, C12.2, C13.2, D3.5 (C4), IC1.P$30 (SIM_VDD), J1.C1 (VCC)
VBAT: J4.P$1, J5.P$1, R7.1, U$4.3 (IP-), U$4.4 (IP-), V_ACCU.2
VBUC: BUC_SPLY.1, F4.1A, J8.P$1, J9.P$1, R12.1
VLOAD: F1.2A, F3.2A, F4.2A, F5.2A, J2.P$1, J3.P$1, U$2.3 (IP-), U$2.4 (IP-)
VMDM: MDM_REG_A.1, MDM_SPLY_HT_X1_X3.5, R4.1, TO_LTC_REG.1, U$3.VIN, U$6.VIN
VPWR_SPLY: K1.P, V_PWR_SPLY.2
VSCADA: D1.C, FAN_A.2, FAN_B.2, K1.1, R16.1, SCADA_REG_A.1, SCADA_SPLY.1
VSCPC: F5.1A, J6.P$1, J7.P$1, R10.1, SCPC_SPLY.1
VSPLY: K1.S, U$2.1 (IP+), U$2.2 (IP+), U$4.1 (IP+), U$4.2 (IP+)

Notes on the sheet:
Drawn by:
Checked by:
FLYFISH TECHNOLOGIES d.o.o.
Ivan Zilic
v0.1

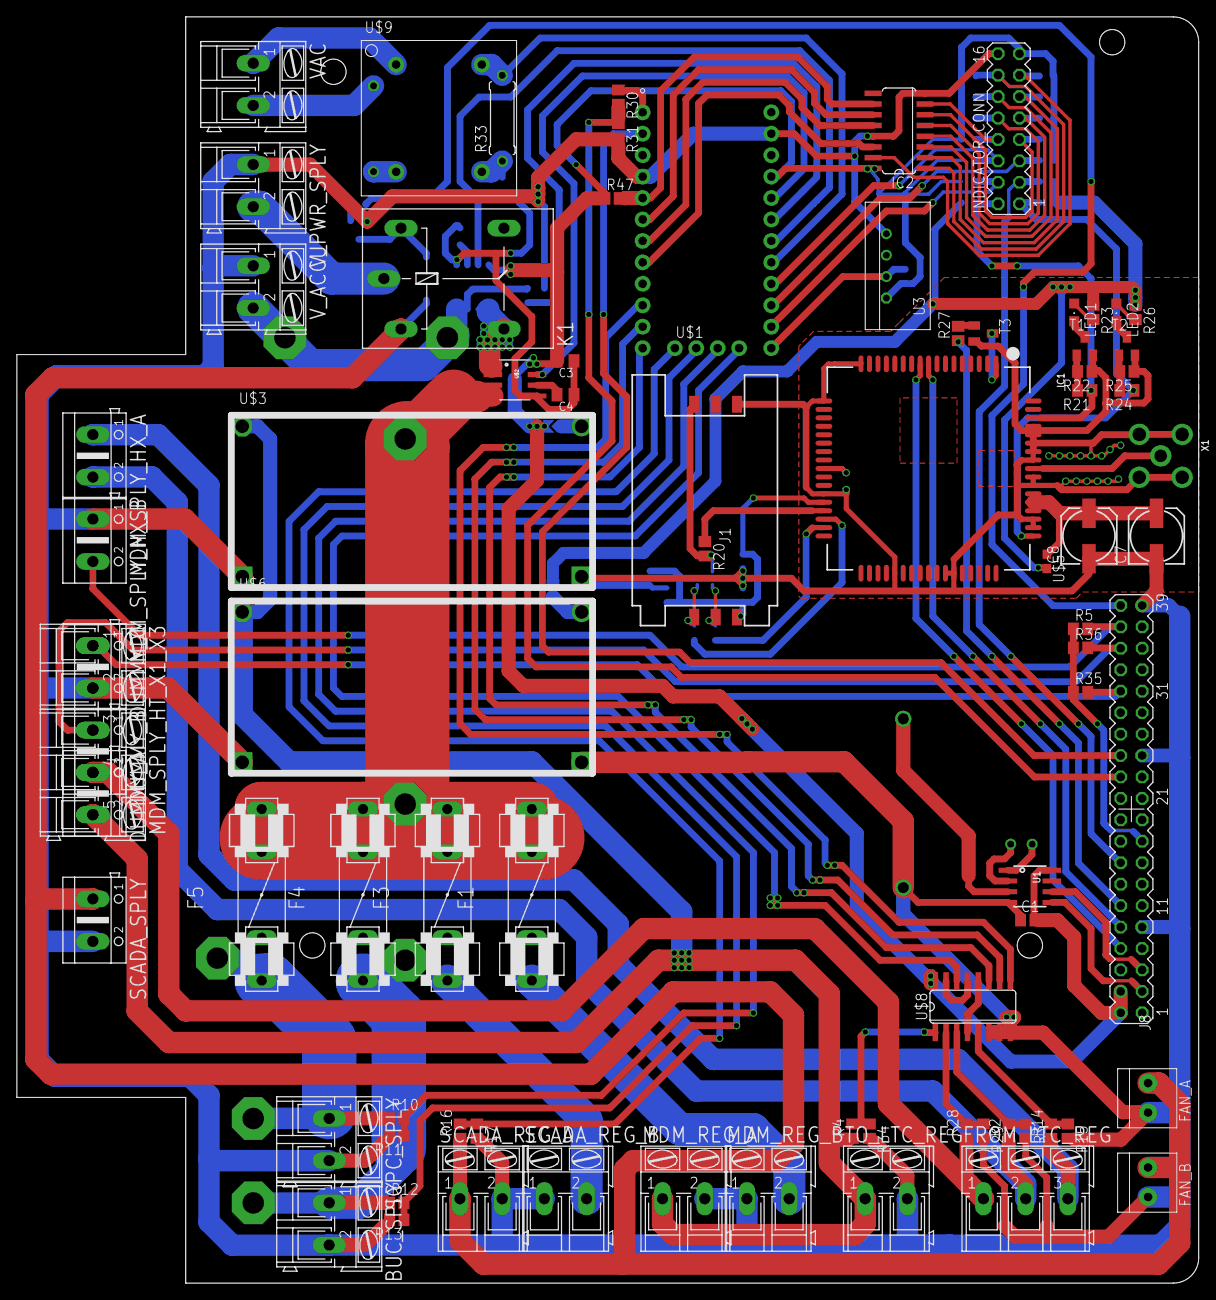
[picture p14: board sr_controller_v1_revA.brd from above]

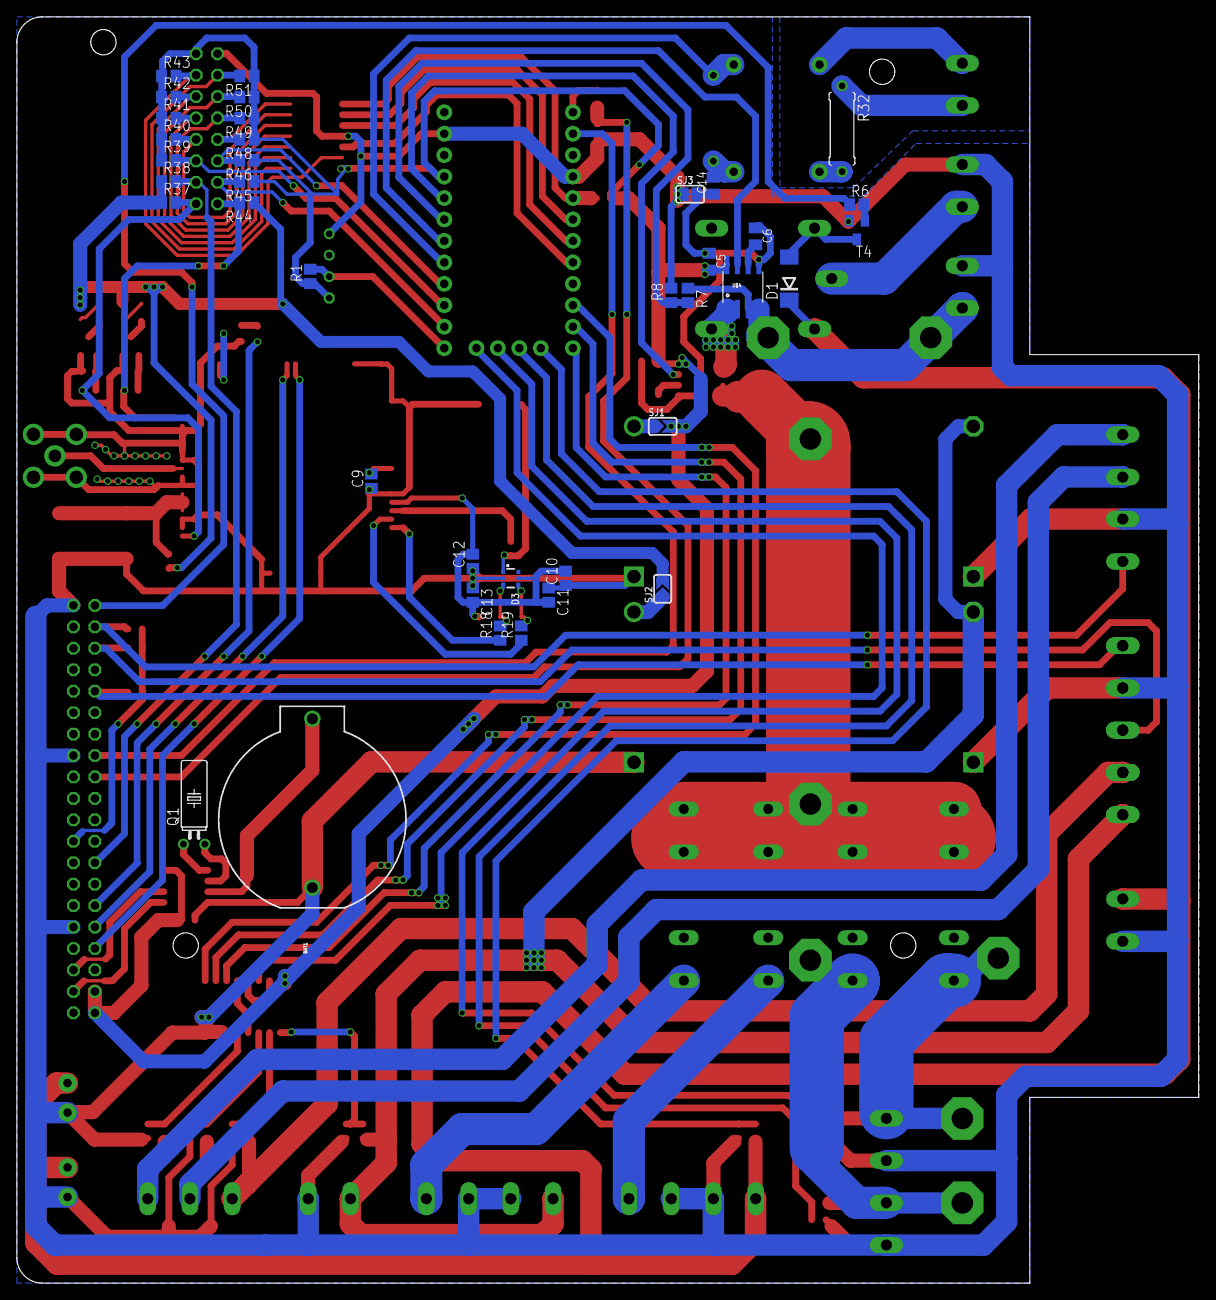
[picture p15: board sr_controller_v1_revA.brd from below]

Board: 2 copper layers, 140.0 x 150.0 mm, 125 parts (38 on the bottom side), 97 nets.
