christiantigor/smart_rectifier/board_sr/sr_controller_v1/sr_controller_v1_revE.brd

## EAGLE design board_sr/sr_controller_v1/sr_controller_v1_revE.brd (2017-06-01)

Schematic: sr_controller_v1_revE.sch

Parts:
ADJ_VPWRSPLY: AK300/2
B1: RB1A
BAT1: BATTERY20PTH; BATTCOM_20MM_PTH
C1: C4.7uF; C0805
C2: C470uF; E3,5-8
C3, C5: C100nF; C0805K
C4, C6: C1nF; C0805K
D1, D2: 1N4004; DO41-10
D3: 1N4728; DO41Z10
F1, F2, F3: 5A; BLADE_FUSE_HOLDER
FAN: HEADER_1X02
FROM_GREY_REG: AK300/2
FROM_LTC_REG_A: AK300/2
FROM_LTC_REG_B: AK300/2
IC3: LM741D; SO08
INDICATOR_CONN: MA03-2
LED1: LEDCHIP-LED0805; CHIP-LED0805
OUT_+6V5, OUT_+12V, OUT_+13V5, OUT_+19V5, OUT_+24V, OUT_+48V_A, OUT_+48V_B: MKDSN1,5/2-5,08
PCB1: RASPBERRY_PI_B+_NO_MOUNT; RASPBERRY_PI_B+
Q1: 32kHz; TC38H
Q2: BD140; TO126AV
R1, R2, R4, R7, R9, R10, R12, R14, R15, R16, R24, R25, R26, R27, R28, R54: R10K; R0805
R3, R31, R34: R2K; R0805
R5: R150K; R0805
R6: R100K; R0805
R8, R18: R220R; R0805
R11, R13, R20, R21, R30, R53: R1K; R0805
R17, R22, R29: R5.1K; R0805
R32: R270K; 0309/10
R33: R5.1K; 0309/10
R55: R10K; P642
R57: R47R; R0805
RPI_RESET: TAC_SWITCHPTH; TACTILE-PTH
SJ1, SJ2: SOLDERJUMPER; SOLDERJUMPER_ARROW_NOPASTE
SJ3: SOLDERJUMPERCLOSED; SOLDERJUMPER_CLOSEDWIRE
SJ6: SOLDERJUMPERREFLOW; SOLDERJUMPER_REFLOW
T1: MMBT2222ALT1-NPN-SOT23-BEC; SOT23-BEC
TO_GREY_REG: AK300/2
TO_LTC_REG: AK300/2
TV16: TRANSFORMER; TV16
U1: RTC_DS1307; SOIC8_150MIL
U3: RHT03_DHT-22_AM2302; RHT03_DHT-22
U$1: ARDUINO_PRO_MINI
U$2, U$4: ACS712; SO08
U$3, U$6: DCDCMODULE
U$7, U$8: 74HC4053D; SO16
VAC: AK300/2
VPWRSPLY&VBAT: AK300/3

Connections:
+3V3: INDICATOR_CONN.5, LED1.A, R24.1, R25.1, R26.1, R27.1, SJ2.2
+5V: C1.2, C3.2, C5.2, PCB1.2 (5V0), PCB1.4 (5V0), R1.1, R21.2, SJ1.2, U1.8 (VCC), U3.VDD, U$1.21 (VCC), U$2.8 (VCC), U$4.8 (VCC), U$7.16 (VCC), U$8.16 (VCC)
+6V5: FROM_LTC_REG_B.2, OUT_+6V5.2, R14.1
+12V: D2.C, FAN.1, FROM_LTC_REG_B.1, IC3.7 (V+), OUT_+12V.2, R5.1, R16.1, R54.1
+13V5: FROM_LTC_REG_A.2, OUT_+13V5.2, R28.1
+19V5: FROM_LTC_REG_A.1, OUT_+19V5.2, R2.1
+24V: FROM_GREY_REG.1, OUT_+24V.2, R4.1, TO_LTC_REG.1, U$3.VIN, U$6.VIN
+48V_A: F2.1, OUT_+48V_A.2, R10.1
+48V_B: F3.1, OUT_+48V_B.2, R12.1
ADJ_VOLTAGE: ADJ_VPWRSPLY.2, R22.2
AGND: C3.1, C4.1, C5.1, C6.1, D3.A, SJ3.2, SJ6.1, U$2.5 (GND), U$4.5 (GND)
ARDU_RX: PCB1.8 (TXD0/GPIO14), U$1.2 (RXI)
ARDU_TX: PCB1.10 (RXD0/GPIO15), R30.2, R31.1
CTRL_CHARGING: PCB1.12 (GPIO18), R20.1
DHT_DATA: R1.2, U3.DATA, U$1.13 (*10)
GND: ADJ_VPWRSPLY.1, BAT1.2 (-), C1.1, FROM_GREY_REG.2, IC3.4 (V-), INDICATOR_CONN.6, OUT_+6V5.1, OUT_+12V.1, OUT_+13V5.1, OUT_+19V5.1, OUT_+24V.1, OUT_+48V_A.1, OUT_+48V_B.1, PCB1.9 (GND), PCB1.25 (GND), PCB1.39 (GND), Q2.C, R3.2, R6.2, R8.2, R11.2, R13.2, R15.2, R17.2, R18.2, R29.2, R31.2, R34.2, R55.1, RPI_RESET.3, RPI_RESET.4, SJ3.1, T1.E, TO_GREY_REG.1, TO_LTC_REG.2, U1.4 (GND), U3.GND, U$1.4 (GND), U$1.23 (GND), U$3.GND#0 (GNDI), U$3.GND#1 (GNDO), U$6.GND#0 (GNDI), U$6.GND#1 (GNDO), U$7.6 (/E), U$7.7 (VEE), U$7.8 (GND), U$8.6 (/E), U$8.7 (VEE), U$8.8 (GND), VPWRSPLY&VBAT.1
INDC_HEALTH_BLUE: INDICATOR_CONN.3, PCB1.35 (GPIO19), R26.2
INDC_HEALTH_GREEN: INDICATOR_CONN.2, PCB1.38 (GPIO20), R25.2
INDC_HEALTH_RED: INDICATOR_CONN.1, PCB1.37 (GPIO26), R24.2
INDC_SPLY_OUTS: INDICATOR_CONN.4, PCB1.36 (GPIO16), R27.2
unnamed: R32.1, VAC.2
unnamed: TV16.IB, VAC.1
unnamed: Q1.2, U1.1 (X1)
unnamed: Q1.1, U1.2 (X2)
unnamed: BAT1.1 (+), U1.3 (VBAT)
unnamed: U$8.13 (1Y1), U$8.15 (2Z)
unnamed: U$8.4 (3Z), U$8.12 (1Y0)
unnamed: SJ1.1, U$3.VOUT
unnamed: SJ2.1, U$6.VOUT
unnamed: C4.2, U$2.6 (FILT)
unnamed: U$7.13 (1Y1), U$7.15 (2Z)
unnamed: LED1.C, R53.1
unnamed: IC3.3 (+IN), R54.2, R55.2
unnamed: C6.2, U$4.6 (FILT)
unnamed: F1.1, TO_GREY_REG.2
unnamed: IC3.2 (-IN), R5.2, R6.1
unnamed: D1.A, R21.1, T1.C
unnamed: D2.A, FAN.2, Q2.E
unnamed: B1.AC1, R33.2, TV16.OA
unnamed: R20.2, T1.B
unnamed: D1.C, R22.1
unnamed: B1.-, C2.-, SJ6.2
unnamed: U$7.4 (3Z), U$7.12 (1Y0)
unnamed: R30.1, U$1.1 (TXO)
unnamed: R32.2, TV16.IA
unnamed: B1.AC2, R33.1, TV16.OB
unnamed: IC3.6 (OUT), R57.2
unnamed: Q2.B, R57.1
RPI_RESET: PCB1.32 (GPIO12), R53.2, RPI_RESET.1, RPI_RESET.2
RTC_SCL: PCB1.5 (GPIO3/SCL1), U1.6 (SCL)
RTC_SDA: PCB1.3 (GPIO2/SDA1), U1.5 (SDA)
SEL_SENSOR_1: U$1.14 (*11), U$7.11 (S1), U$8.11 (S1)
SEL_SENSOR_2: U$1.15 (12), U$7.9 (S3), U$7.10 (S2), U$8.9 (S3), U$8.10 (S2)
SENSOR_+6V5: R14.2, R15.1, U$8.5 (3Y0)
SENSOR_+12V: R16.2, R17.1, U$8.3 (3Y1)
SENSOR_+13V5: R28.2, R29.1, U$8.2 (2Y0)
SENSOR_+19V5: R2.2, R3.1, U$8.1 (2Y1)
SENSOR_+24V: R4.2, R34.1, U$7.5 (3Y0)
SENSOR_+48V_A: R10.2, R11.1, U$7.2 (2Y0)
SENSOR_+48V_B: R12.2, R13.1, U$7.3 (3Y1)
SENSOR_IBAT: U$1.18 (A1), U$4.7 (VOUT)
SENSOR_ILOAD: U$1.17 (A0), U$2.7 (VOUT)
SENSOR_SPLY_A: U$1.28 (A7), U$7.14 (1Z)
SENSOR_SPLY_B: U$1.27 (A6), U$8.14 (1Z)
SENSOR_VAC: B1.+, C2.+, D3.C, U$1.20 (A3)
SENSOR_VBAT: R7.2, R8.1, U$7.1 (2Y1)
SENSOR_VPWRSPLY: R9.2, R18.1, U$1.19 (A2)
VBAT: R7.1, U$4.3 (IP-), U$4.4 (IP-), VPWRSPLY&VBAT.3
VLOAD: F1.2, F2.2, F3.2, U$2.3 (IP-), U$2.4 (IP-)
VPWRSPLY: R9.1, U$2.1 (IP+), U$2.2 (IP+), U$4.1 (IP+), U$4.2 (IP+), VPWRSPLY&VBAT.2

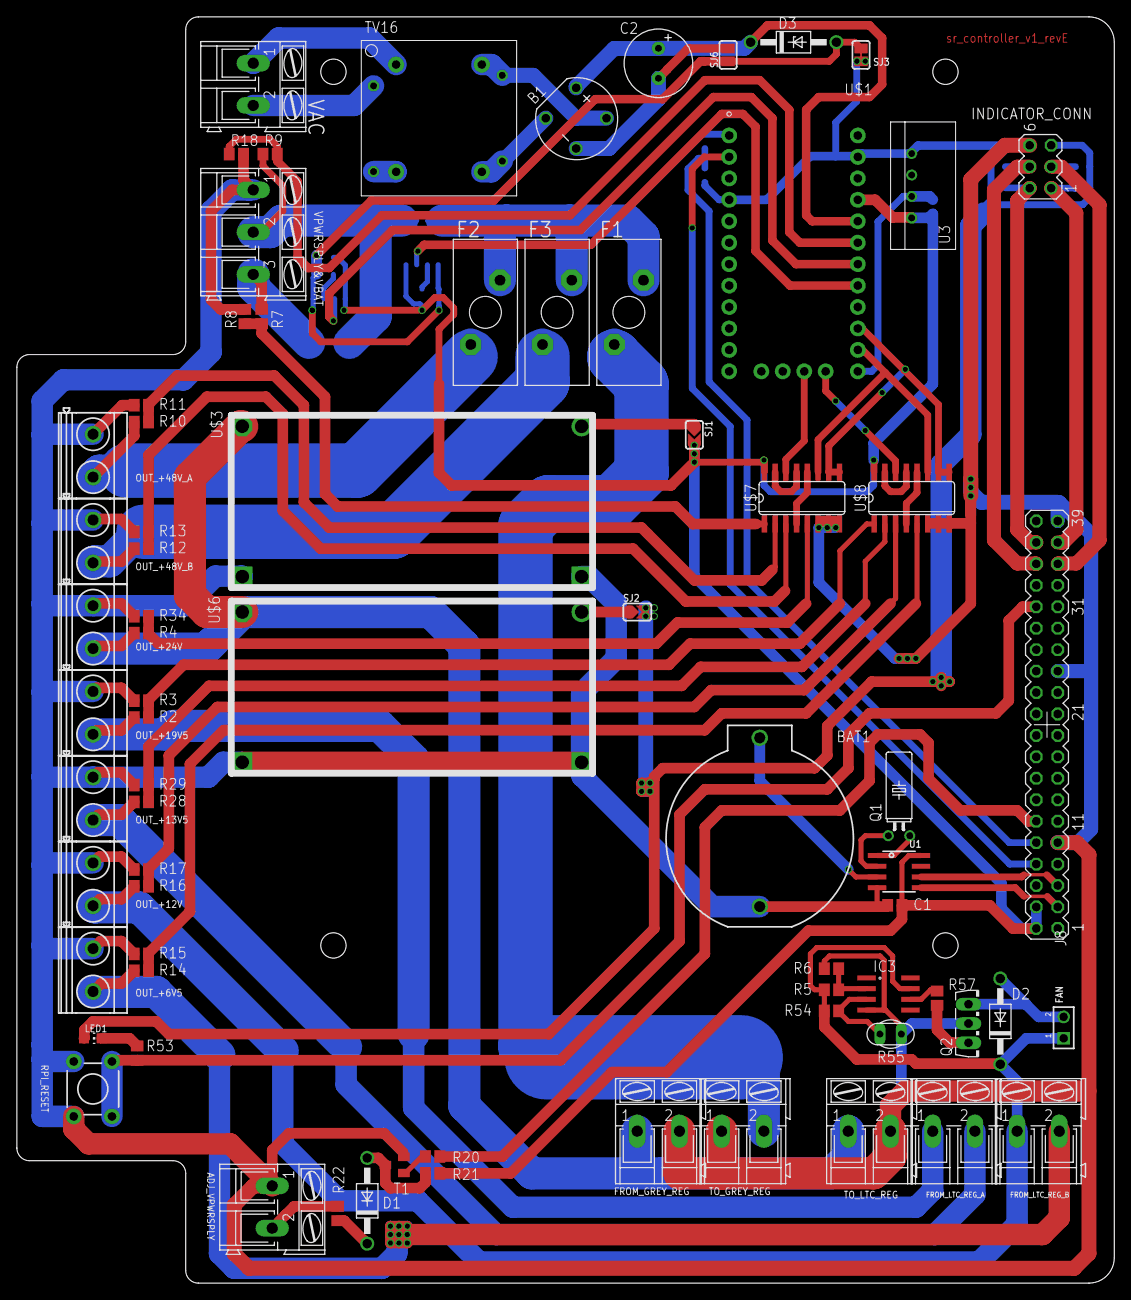
[picture p16: board sr_controller_v1_revE.brd from above]

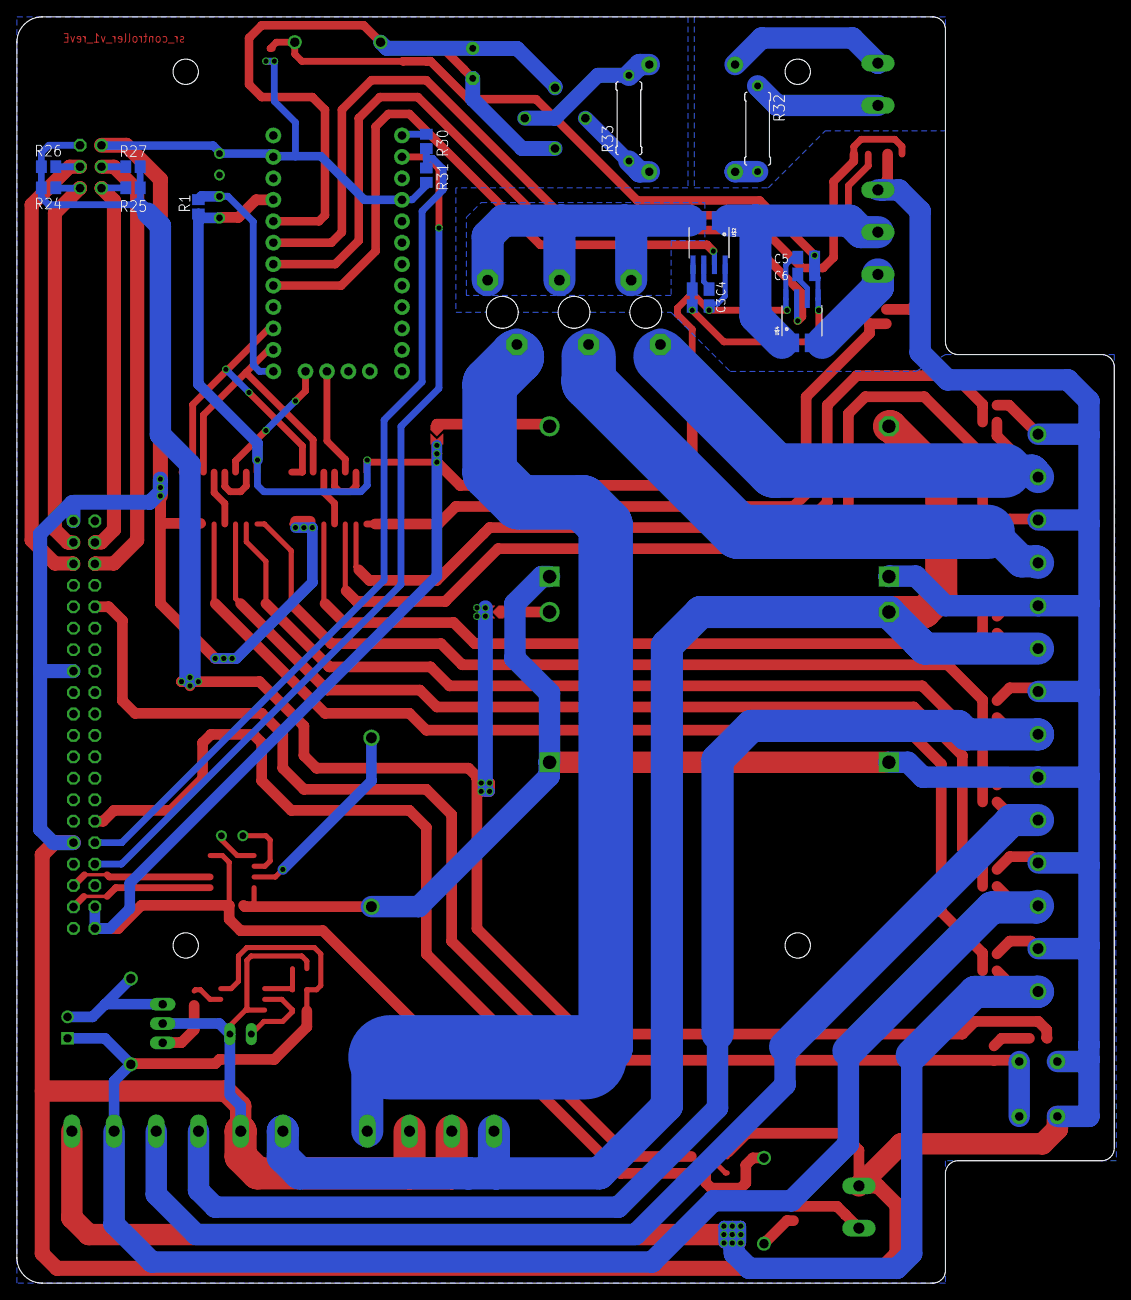
[picture p17: board sr_controller_v1_revE.brd from below]

Board: 2 copper layers, 130.0 x 150.0 mm, 88 parts (15 on the bottom side), 70 nets.
