christiantigor/smart_rectifier/board_sr/sr_indicator_v0/sr_indicator_v0_revB.brd

## EAGLE design board_sr/sr_indicator_v0/sr_indicator_v0_revB.brd (2017-06-01)

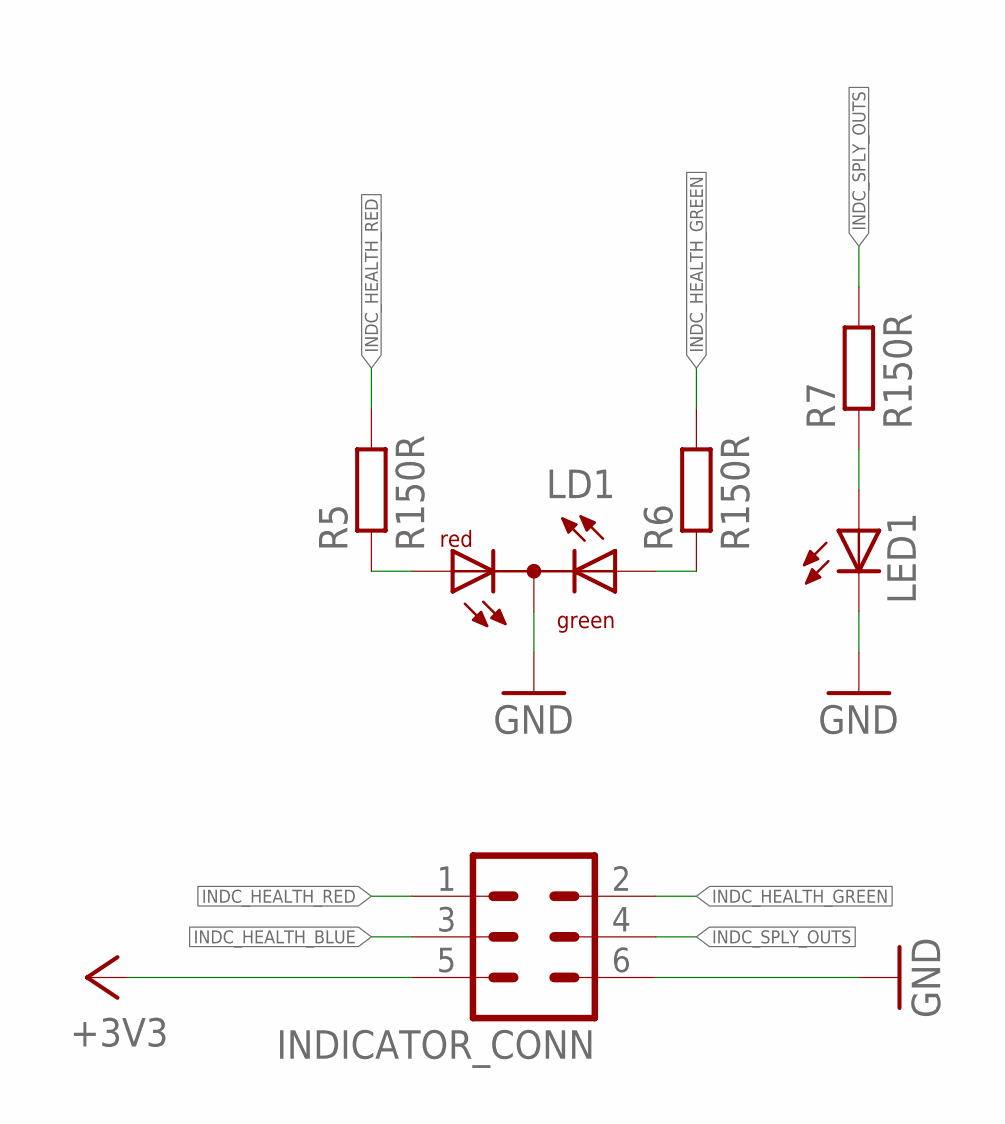
[picture p18: schematic sr_indicator_v0_revB.sch]

Parts:
INDICATOR_CONN: MA03-2
LD1: DUOLED-RG-C; DUOLED-C-5MM
LED1: LED5MM
R5, R6, R7: R150R; M0805

Connections:
+3V3: INDICATOR_CONN.5
GND: INDICATOR_CONN.6, LD1.C, LED1.K (C)
INDC_HEALTH_BLUE: INDICATOR_CONN.3
INDC_HEALTH_GREEN: INDICATOR_CONN.2, R6.2
INDC_HEALTH_RED: INDICATOR_CONN.1, R5.2
INDC_SPLY_OUTS: INDICATOR_CONN.4, R7.2
unnamed: LD1.AR, R5.1
unnamed: LD1.AX (AG), R6.1
unnamed: LED1.A, R7.1

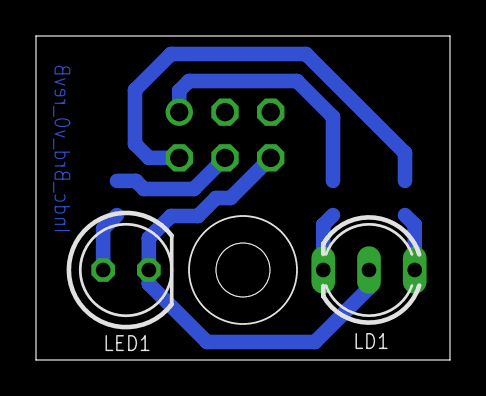
[picture p19: board sr_indicator_v0_revB.brd from above]

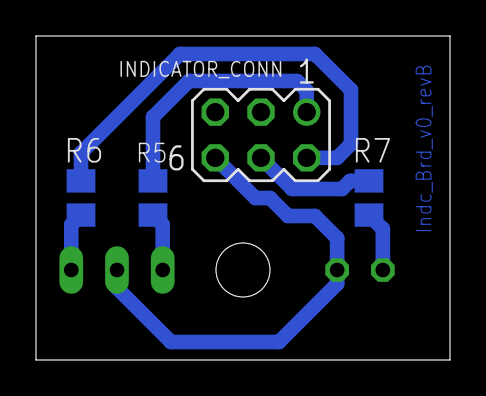
[picture p20: board sr_indicator_v0_revB.brd from below]

Board: 2 copper layers, 23.0 x 18.0 mm, 6 parts (4 on the bottom side), 7 nets.
