christiantigor/smart_rectifier/board_sr/ltc_adaptor_v0/ltc_adaptor_v0.brd

## EAGLE design board_sr/ltc_adaptor_v0/ltc_adaptor_v0.brd (2016-06-01)

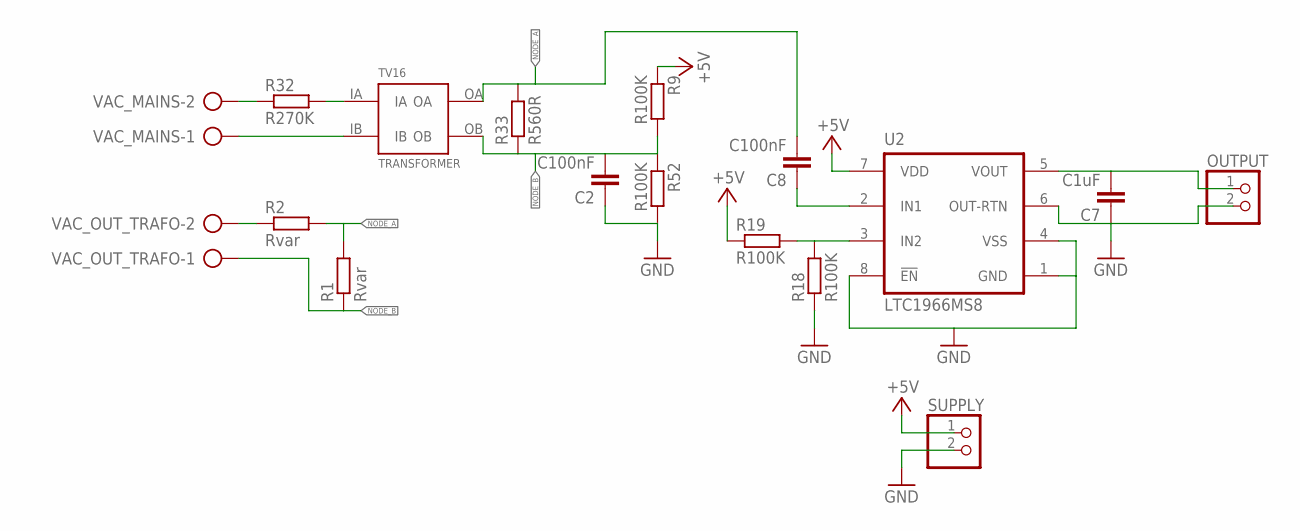
[picture p21: schematic ltc_adaptor_v0.sch]

Parts:
C2, C8: C100nF; C0805K
C7: C1uF; C0805K
OUTPUT: HEADER-1X2ROUND; 1X02_ROUND
R1, R2: Rvar; R0805
R9, R18, R19, R52: R100K; R0805
R32: R270K; 0309/10
R33: R560R; 0309/10
SUPPLY: HEADER-1X2ROUND; 1X02_ROUND
TV16: TRANSFORMER; TV16
U2: LTC1966MS8; MSOP08
VAC_MAINS: AK300/2
VAC_OUT_TRAFO: AK300/2

Connections:
+5V: R9.1, R19.1, SUPPLY.1, U2.7 (VDD)
GND: C2.1, C7.1, OUTPUT.2, R18.1, R52.2, SUPPLY.2, U2.1 (GND), U2.4 (VSS), U2.6 (OUT-RTN), U2.8 (!EN!)
unnamed: R32.1, VAC_MAINS.2
unnamed: TV16.IB, VAC_MAINS.1
unnamed: R2.1, VAC_OUT_TRAFO.2
unnamed: C7.2, OUTPUT.1, U2.5 (VOUT)
unnamed: R18.2, R19.2, U2.3 (IN2)
unnamed: C8.1, U2.2 (IN1)
unnamed: R32.2, TV16.IA
NODE_A: C8.2, R1.2, R2.2, R33.2, TV16.OA
NODE_B: C2.2, R1.1, R9.2, R33.1, R52.1, TV16.OB, VAC_OUT_TRAFO.1

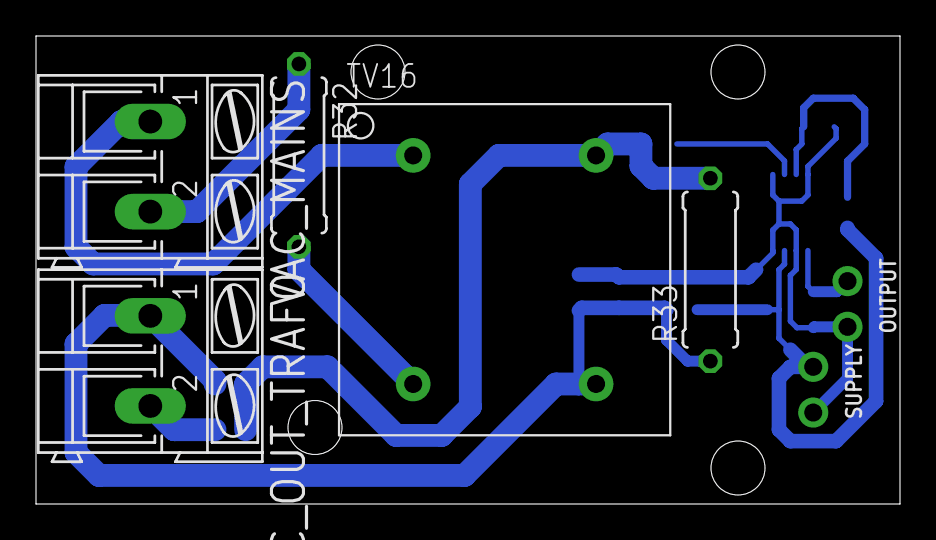
[picture p22: board ltc_adaptor_v0.brd from above]

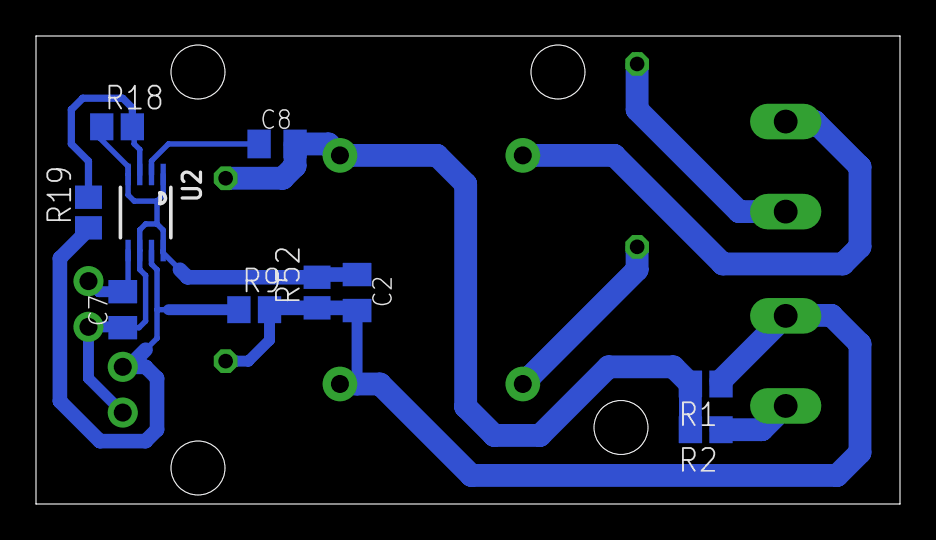
[picture p23: board ltc_adaptor_v0.brd from below]

Board: 2 copper layers, 48.0 x 26.0 mm, 17 parts (10 on the bottom side), 11 nets.
