christiantigor/smart_rectifier/board_sr/sr_indicator_v0/sr_indicator_v0_revA.brd

## EAGLE design board_sr/sr_indicator_v0/sr_indicator_v0_revA.brd (2016-06-01)

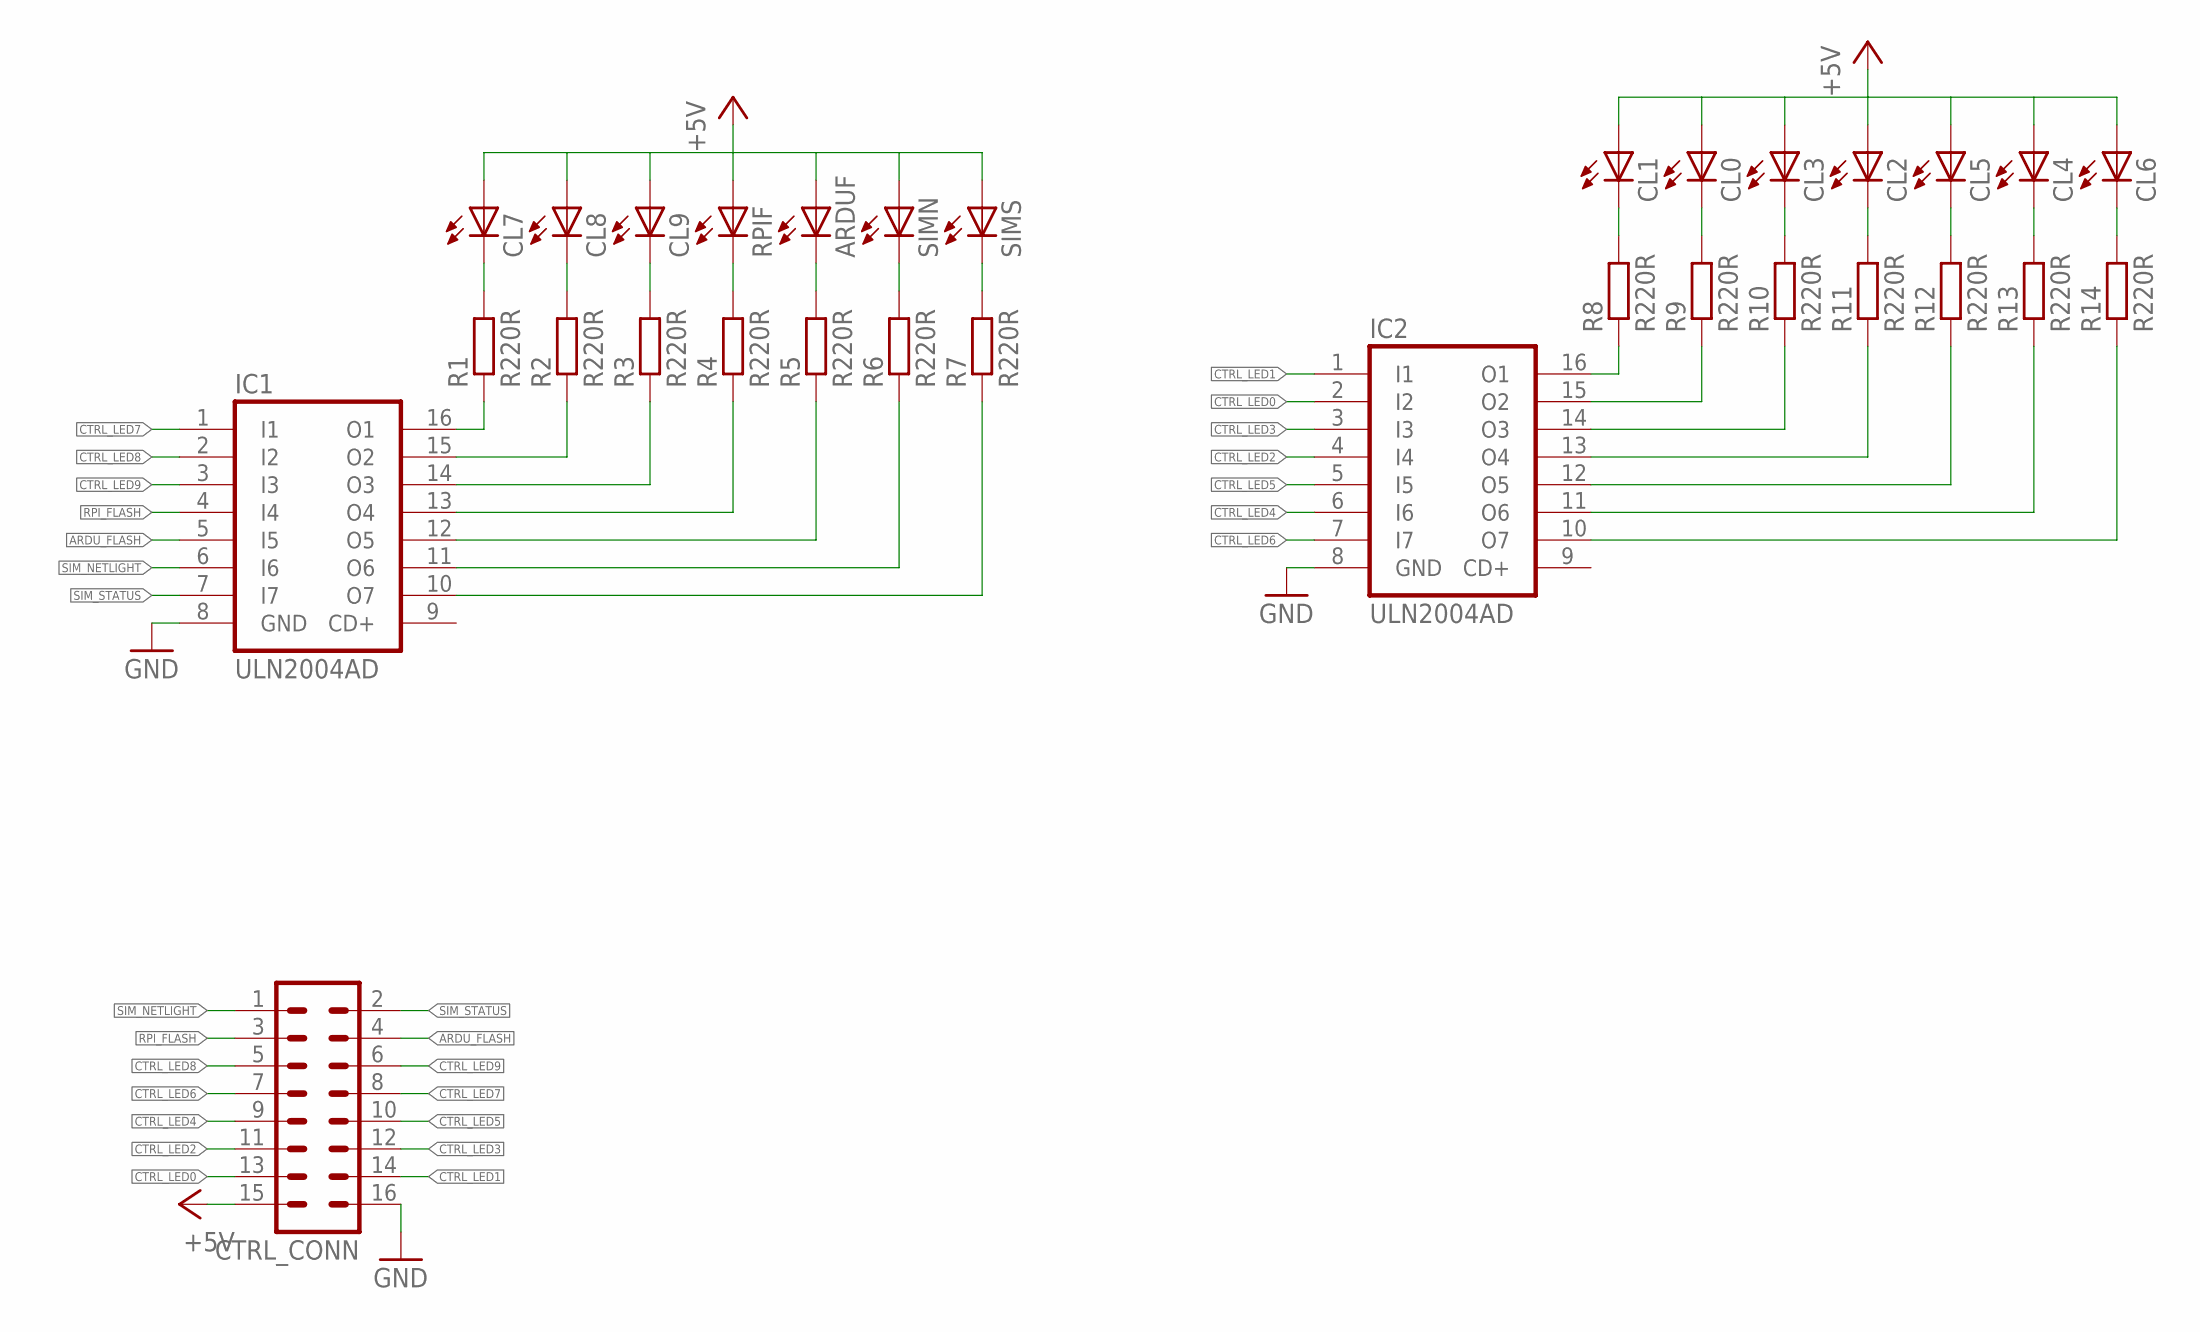
[picture p24: schematic sr_indicator_v0_revA.sch]

Parts:
ARDUF: LED3MM
CL0, CL1, CL2, CL3, CL4, CL5, CL6, CL7, CL8, CL9: LED3MM
CTRL_CONN: MA08-2
IC1, IC2: ULN2004AD; SO16
R1, R2, R3, R4, R5, R6, R7, R8, R9, R10, R11, R12, R13, R14: R220R; M0805
RPIF: LED3MM
SIMN: LED3MM
SIMS: LED3MM

Connections:
+5V: ARDUF.A, CL0.A, CL1.A, CL2.A, CL3.A, CL4.A, CL5.A, CL6.A, CL7.A, CL8.A, CL9.A, CTRL_CONN.15, RPIF.A, SIMN.A, SIMS.A
ARDU_FLASH: CTRL_CONN.4, IC1.5 (I5)
CTRL_LED0: CTRL_CONN.13, IC2.2 (I2)
CTRL_LED1: CTRL_CONN.14, IC2.1 (I1)
CTRL_LED2: CTRL_CONN.11, IC2.4 (I4)
CTRL_LED3: CTRL_CONN.12, IC2.3 (I3)
CTRL_LED4: CTRL_CONN.9, IC2.6 (I6)
CTRL_LED5: CTRL_CONN.10, IC2.5 (I5)
CTRL_LED6: CTRL_CONN.7, IC2.7 (I7)
CTRL_LED7: CTRL_CONN.8, IC1.1 (I1)
CTRL_LED8: CTRL_CONN.5, IC1.2 (I2)
CTRL_LED9: CTRL_CONN.6, IC1.3 (I3)
GND: CTRL_CONN.16, IC1.8 (GND), IC2.8 (GND)
unnamed: IC1.16 (O1), R1.1
unnamed: IC1.15 (O2), R2.1
unnamed: IC1.14 (O3), R3.1
unnamed: IC1.13 (O4), R4.1
unnamed: IC1.12 (O5), R5.1
unnamed: IC1.11 (O6), R6.1
unnamed: IC1.10 (O7), R7.1
unnamed: CL7.K (C), R1.2
unnamed: CL8.K (C), R2.2
unnamed: CL9.K (C), R3.2
unnamed: R4.2, RPIF.K (C)
unnamed: ARDUF.K (C), R5.2
unnamed: R6.2, SIMN.K (C)
unnamed: R7.2, SIMS.K (C)
unnamed: IC2.16 (O1), R8.1
unnamed: IC2.15 (O2), R9.1
unnamed: IC2.14 (O3), R10.1
unnamed: IC2.13 (O4), R11.1
unnamed: IC2.12 (O5), R12.1
unnamed: IC2.11 (O6), R13.1
unnamed: IC2.10 (O7), R14.1
unnamed: CL1.K (C), R8.2
unnamed: CL0.K (C), R9.2
unnamed: CL3.K (C), R10.2
unnamed: CL2.K (C), R11.2
unnamed: CL5.K (C), R12.2
unnamed: CL4.K (C), R13.2
unnamed: CL6.K (C), R14.2
RPI_FLASH: CTRL_CONN.3, IC1.4 (I4)
SIM_NETLIGHT: CTRL_CONN.1, IC1.6 (I6)
SIM_STATUS: CTRL_CONN.2, IC1.7 (I7)

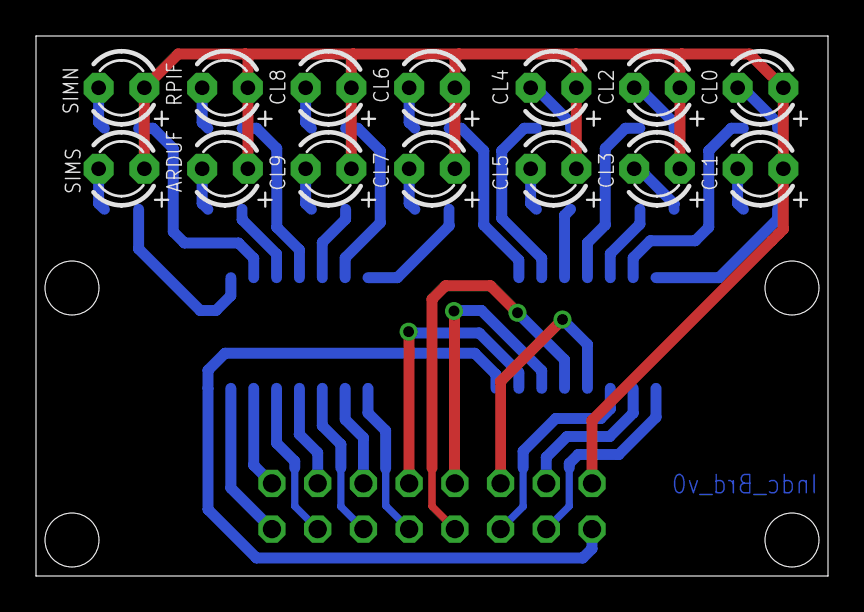
[picture p25: board sr_indicator_v0_revA.brd from above]

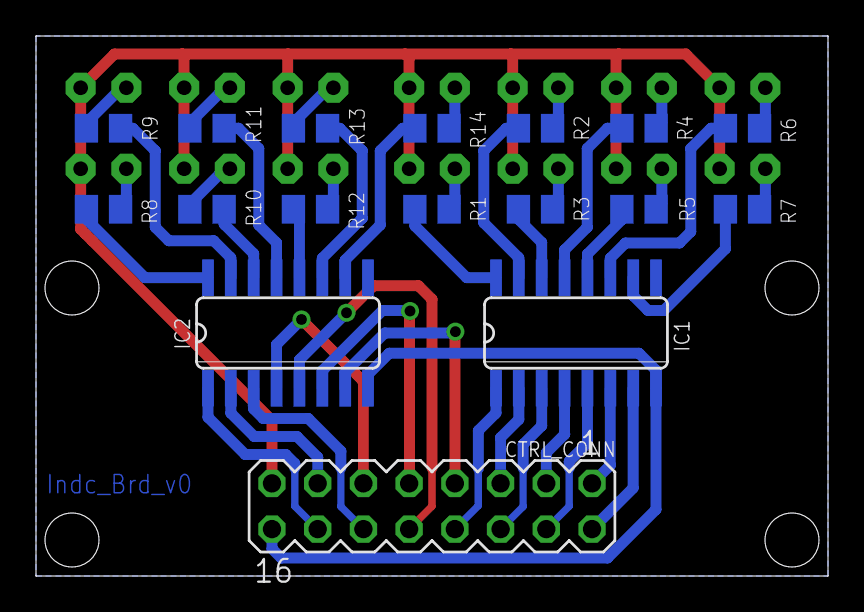
[picture p26: board sr_indicator_v0_revA.brd from below]

Board: 2 copper layers, 44.0 x 30.0 mm, 31 parts (17 on the bottom side), 44 nets.
