christiantigor/smart_rectifier/program_sr/rpi/process/processChecker.py

#!/usr/bin/python

import re
import subprocess
import time

def main():
    #check chargerControl
    cmd = 'ps aux | grep chargerControl.py | grep -v grep'
    psCheck = subprocess.Popen(
        [cmd],
        stdout = subprocess.PIPE,
        stderr = subprocess.PIPE,
        shell = True
    )
    out, err = psCheck.communicate()

    if not bool(re.search('chargerControl.py',out)):
        cmd = 'python chargerControl.py'
        psRun = subprocess.Popen(
            [cmd],
            stdout = subprocess.PIPE,
            stderr = subprocess.PIPE,
            shell = True
        )
        time.sleep(3)
        psRun.terminate()
        psRun.wait()
        print 'start chargerControl.py'
    else:
        print 'chargerControl.py is running'


    #check getSensorData
    cmd = 'ps aux | grep getSensorData.py | grep -v grep'
    psCheck = subprocess.Popen(
        [cmd],
        stdout = subprocess.PIPE,
        stderr = subprocess.PIPE,
        shell = True
    )
    out, err = psCheck.communicate()

    if not bool(re.search('getSensorData.py',out)):
        cmd = 'python getSensorData.py'
        psRun = subprocess.Popen(
            [cmd],
            stdout = subprocess.PIPE,
            stderr = subprocess.PIPE,
            shell = True
        )
        time.sleep(3)
        psRun.terminate()
        psRun.wait()
        print 'start getSensorData.py'
    else:
        print 'getSensorData.py is running'
    

    #check PRTGMiniProbe
    cmd = 'sudo service prtgprobe status'
    psCheck = subprocess.Popen(
        [cmd],
        stdout = subprocess.PIPE,
        stderr = subprocess.PIPE,
        shell = True
    )   
    out, err = psCheck.communicate()
    #print out
        
    if bool(re.search('failed!',out)):
        cmd = 'sudo service prtgprobe start'
        psRun = subprocess.Popen(
            [cmd],
            stdout = subprocess.PIPE,
            stderr = subprocess.PIPE,
            shell = True
        )
        out, err = psRun.communicate()
        print 'start prtgprobe'
    else:
        print 'prtgprobe is running'
    
    #check sendSensorData
    cmd = 'ps aux | grep sendSensorData.py | grep -v grep'
    psCheck = subprocess.Popen(
        [cmd],
        stdout = subprocess.PIPE,
        stderr = subprocess.PIPE,
        shell = True
    )
    out, err = psCheck.communicate()

    if not bool(re.search('sendSensorData.py',out)):
        cmd = 'python sendSensorData.py'
        psRun = subprocess.Popen(
            [cmd],
            stdout = subprocess.PIPE,
            stderr = subprocess.PIPE,
            shell = True
        )
        time.sleep(3)
        psRun.terminate()
        psRun.wait()
        print 'start sendSensorData.py'
    else:
        print 'sendSensorData.py is running'

    #check ledFlasher
    cmd = 'ps aux | grep ledFlasher.py | grep -v grep'
    psCheck = subprocess.Popen(
        [cmd],
        stdout = subprocess.PIPE,
        stderr = subprocess.PIPE,
        shell = True
    )
    out, err = psCheck.communicate()

    if not bool(re.search('ledFlasher.py',out)):
        cmd = 'python ledFlasher.py'
        psRun = subprocess.Popen(
            [cmd],
            stdout = subprocess.PIPE,
            stderr = subprocess.PIPE,
            shell = True
        )
        time.sleep(3)
        psRun.terminate()
        psRun.wait()
        print 'start ledFlasher.py'
    else:
        print 'ledFlasher.py is running'

    #check setDefaultConfig
    cmd = 'ps aux | grep setDefaultConfig.py | grep -v grep'
    psCheck = subprocess.Popen(
        [cmd],
        stdout = subprocess.PIPE,
        stderr = subprocess.PIPE,
        shell = True
    )
    out, err = psCheck.communicate()

    if not bool(re.search('setDefaultConfig.py',out)):
        cmd = 'python setDefaultConfig.py'
        psRun = subprocess.Popen(
            [cmd],
            stdout = subprocess.PIPE,
            stderr = subprocess.PIPE,
            shell = True
        )
        time.sleep(3)
        psRun.terminate()
        psRun.wait()
        print 'start setDefaultConfig.py'
    else:
        print 'setDefaultConfig.py is running'

if __name__ == '__main__':
    main()
