christiantigor/smart_rectifier/program_sr/ardu/testDHT11/testDHT11.ino

#include "DHT.h"

#define DHTPIN 10
#define DHTTYPE DHT11

DHT dht(DHTPIN, DHTTYPE);

void setup() {
  Serial.begin(9600);
  Serial.println("DHT11 test!");
  dht.begin();
}

void loop() {
  delay(2000);
  float h = dht.readHumidity();
  float t = dht.readTemperature();
  
  if (isnan(h) || isnan(t)) {
    Serial.println("Failed to read DHT11!");
    return;
  }
  
  Serial.print("Temp:");
  Serial.print(t);
  Serial.println(" *C ");
}
