christiantigor/smart_rectifier/(commit log)

2015-10-07 Placing Components
    [rectifier-monitoring-v2.brd, rectifier-monitoring-v2.sch, sr_controller_v0.brd, sr_controller_v0.sch]
2015-10-08 Update schematic
    [sr_controller_v0.brd, sr_controller_v0.sch]
2015-10-19 Update PCB design
    [User Library-AC Male Socket with Fuse.stl, User Library-Switch MIRS-101-2C Red.stl, sr_controller_v0.brd, sr_controller_v0.sch, sr_controller_v0.stl, sr_controller_v1.brd, sr_controller_v1.sch]
2015-10-21 Backup routing pcb
    [sr_controller_v1.brd, sr_controller_v1.sch, sr_indicator_v0.brd, sr_indicator_v0.sch]
2015-10-22 Finish routing
    [sr_controller_v1.brd, sr_controller_v1.sch, sr_indicator_v0.brd, sr_indicator_v0.sch]
2015-10-29 Finish Routing PCB ver1 revA
    [sr_controller_v1.brd, sr_controller_v1.sch, sr_controller_v1_revA.brd, sr_controller_v1_revA.sch]
2015-11-05 Add Casing CAD Drawing
    [sr_controller_v1_revA.brd, sr_controller_v1_revA.sch]
2015-11-06 Update casing
    [sr_indicator_v0.stl, sr_indicator_v0_revA.brd, sr_indicator_v0_revA.sch]
2015-11-17 Initial commit of getSensorData
    [sensorCalibration.xlsx, sr_controller_v1_revA.brd, sr_controller_v1_revA.sch]
2015-11-21 Update sensor code to del data from DB after read
    [sr_controller_v1_revA.brd, sr_controller_v1_revA.sch]
2015-11-24 Update arduino code and charging test
    Update adc read by mean of samples; charging with and without BUC load
    [chargingLoad.xlsx, chargingLoadData.csv, chargingWOLoad.xlsx, chargingWOLoadData.csv]
2015-11-29 Add sticker data and update Ardu and RPi code
    Ardu - add indicator
    RPi - TSR Cloud connect with ETH and GPRS
    RPi - Set max DB size for local backup
    [vacCalibration.xlsx]
2016-04-19 Create sr_controller_v1_revB
    [sr_controller_v1_revB.brd, sr_controller_v1_revB.sch]
2016-06-01 Publish sr_controller_v1_revC
    [TSR_v1_VAC.xlsx, ltc_adaptor_v0.brd, ltc_adaptor_v0.sch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]
2016-06-01 Update sr_controller_v1_revC
    [sr_controller_v1_revC.brd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]
2016-06-22 Add sr_controller_v1_revD
    [sr_controller_v1_revD.brd, sr_controller_v1_revD.sch]
2016-08-24 Update Arduino Code
2016-08-30 Create Arduino code for production board
    Move measurement coefficient from Arduino to RPi
2016-08-30 Update ledFlasher script
2016-08-30 Add resetDevice script
    Device will reset if you press button more than 5 second
    [ledFlasher.py]
2017-06-01 Urgent Update board_sr only
    Commited & Pussed by Maula
    [sr_controller_v1_revA.brd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]
